GraniteGobbler/VFDClock/README.md

# VFDClock
A table clock with 7-segment VFD tubes running on an ESP32-S3 MCU.

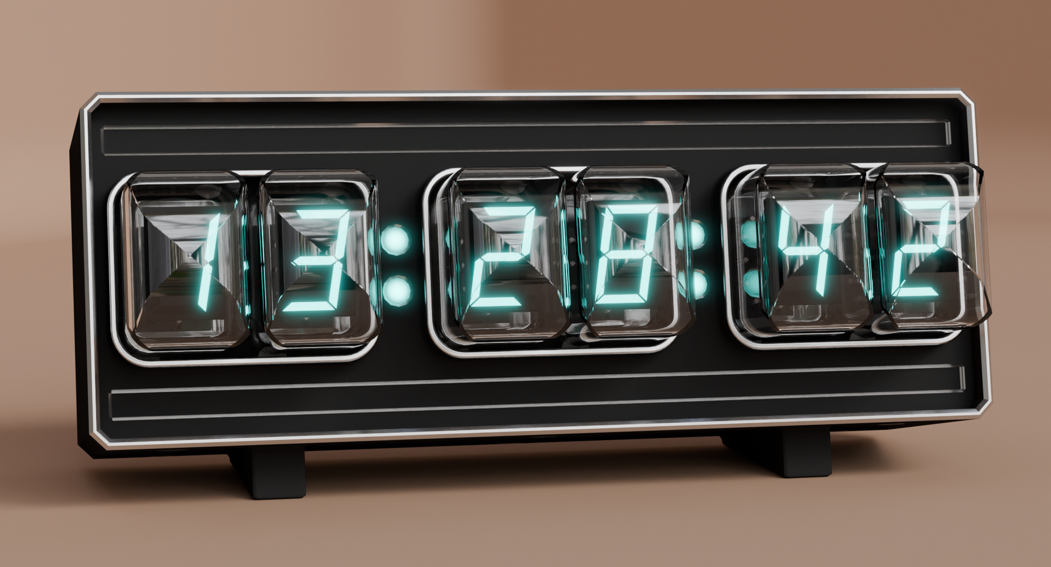
[picture p1: img/render_crop.png]
Front Render


## Showcase
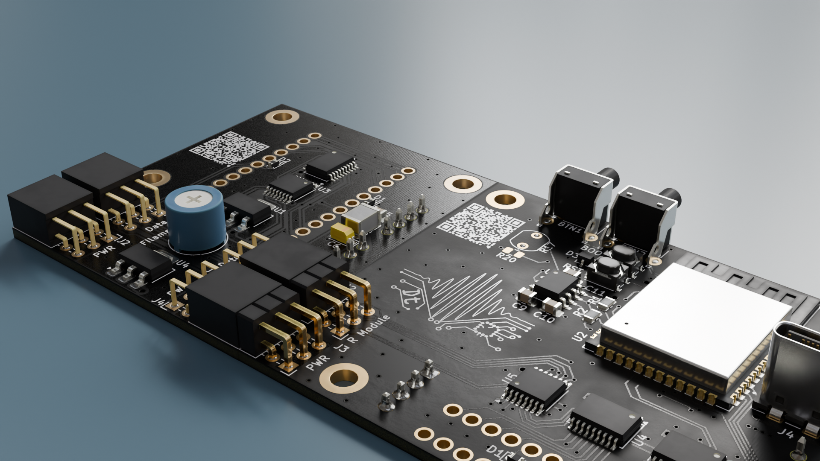
[picture p2: img/PCB renders/assembly_top_detail.png]
Board Assembly
