GraniteGobbler/VFDClock/img/PCB renders/bottom.png

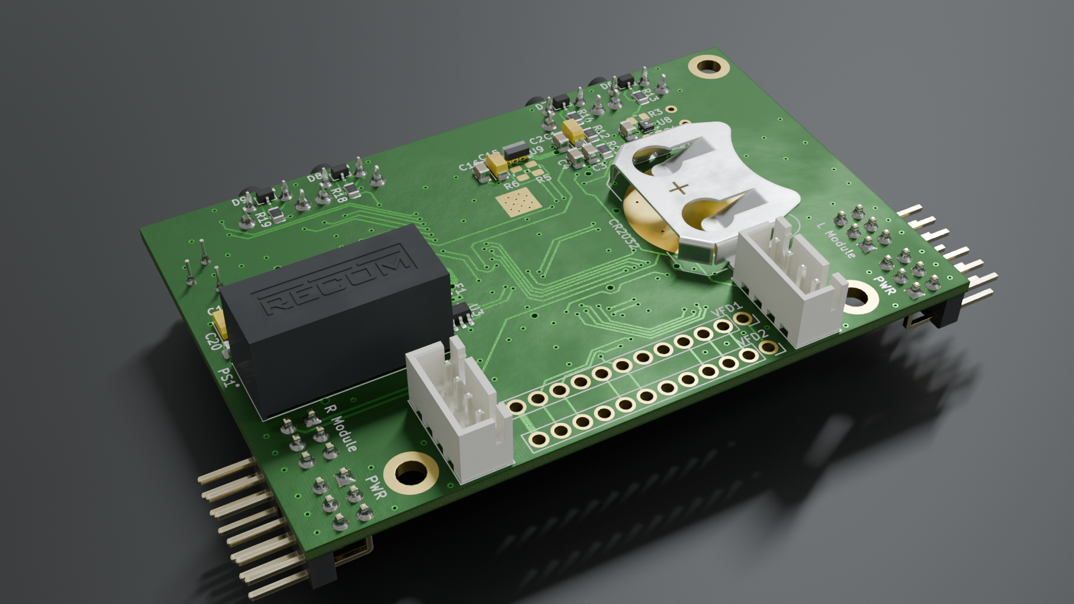
img/PCB renders/bottom.png
