GraniteGobbler/VFDClock/img/PCB renders/top.png

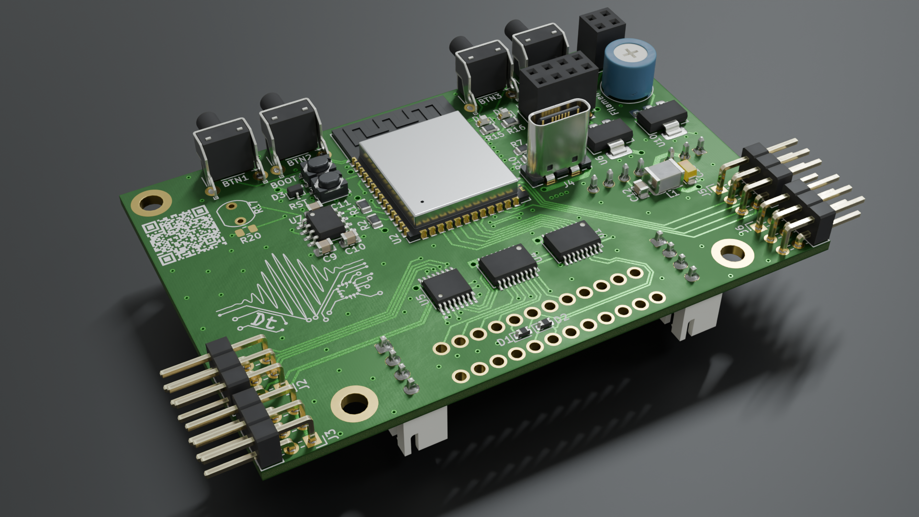
img/PCB renders/top.png
