GraniteGobbler/VFDClock/img/render1.png

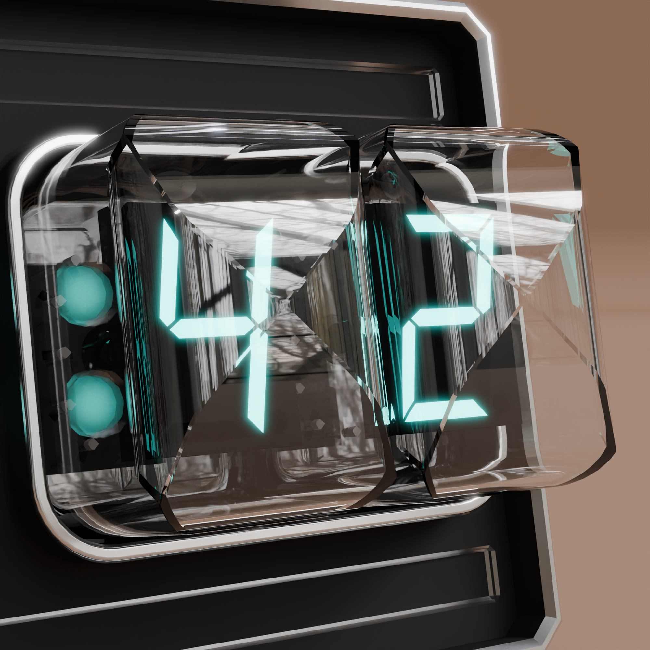
img/render1.png
