GraniteGobbler/VFDClock/img/render.png

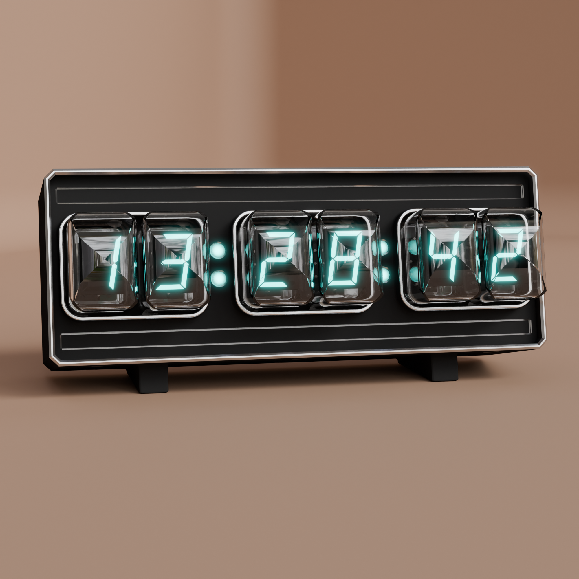
img/render.png
