GraniteGobbler/VFDClock/img/repo_social.png

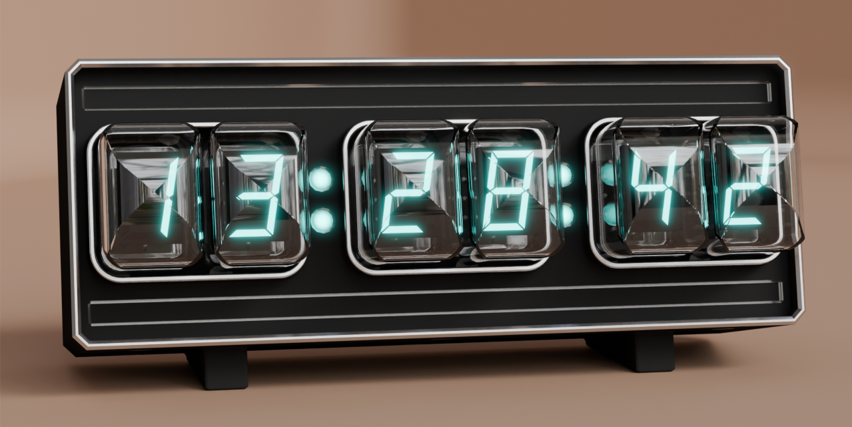
img/repo_social.png
