GraniteGobbler/VFDClock/pcb/pinout.png

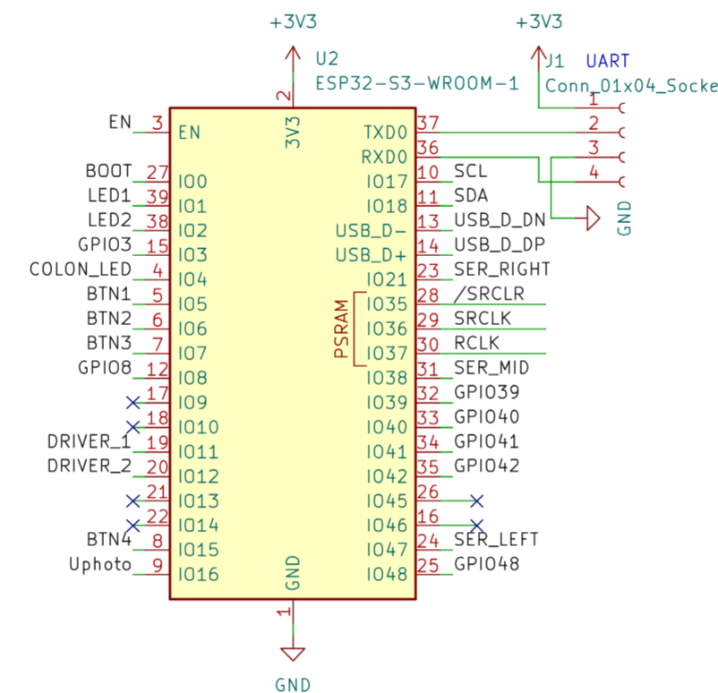
pcb/pinout.png
