GraniteGobbler/VFDClock/hw/VFDClock_assembly.SLDASM

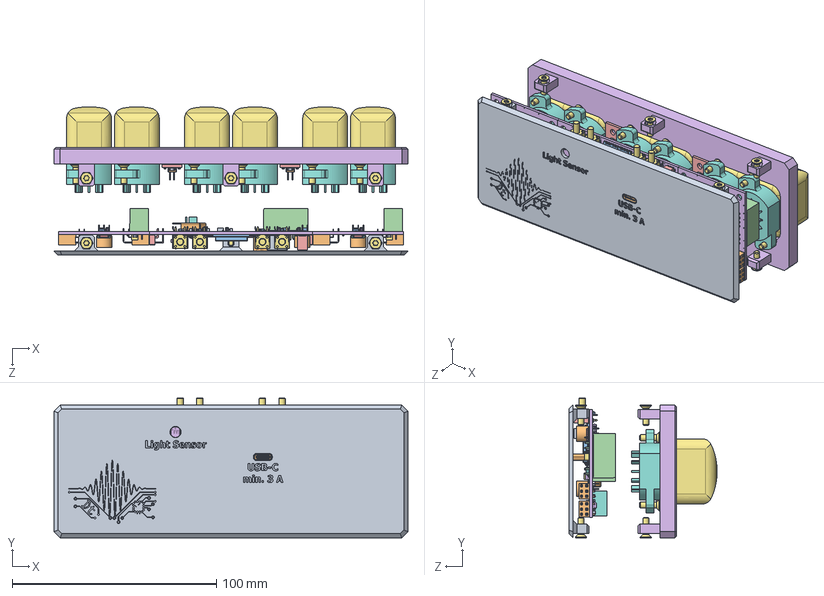
[picture p9: CAD file, 2025-09-25]
hw/VFDClock_assembly.SLDASM
173.3 x 68.4 x 72.6 mm
PinSocket_2x03_P2.54mm_Horizontal.step x 8
D_0603_1608Metric.step x 6
TSSOP-16_4.4x5mm_P0.65mm.step x 3
SSOP-18_4.4x6.5mm_P0.65mm.step x 4
CP_EIA-3216-18_Kemet-A.step x 11
L_1812_4532Metric.step x 3
SOT-223.step x 6
C_0805_2012Metric.step x 27
Potentiometer_Bourns_3339P_Vertical.step x 3
CP_EIA-3528-15_AVX-H.step x 6
Module 1.22.step x 2
Module_silkscreen.step x 2
Module_PCB.step x 2
terminal^Vishay_-_VEML3235SL.step.step
base.step.step
top^Vishay_-_VEML3235SL.step.step
logo^Vishay_-_VEML3235SL.step.step
SOT-323_SC-70.step x 5
LED_0603_1608Metric.step x 2
PinHeader_2x03_P2.54mm_Horizontal.step x 4
R_0805_2012Metric.step x 23
SW_Tactile_SPST_Angled_PTS645Vx83-2LFS.step x 4
PTS810SJK250SMTR_LFS-v2.step x 2
PinSocket_2x04_P2.54mm_Vertical_SMD.step
UJ20-C-V-C-2-SMT-TR-v2.step
ESP32-S3-WROOM-1.step
SOIC-8_3.9x4.9mm_P1.27mm.step
PinSocket_2x02_P2.54mm_Vertical_SMD.step
R_LDR_5.1x4.3mm_P3.4mm_Vertical.step
Fuse_0603_1608Metric.step
JST_XH_B4B-XH-A_1x04_P2.50mm_Vertical.step x 2
SC-74-6_1.55x2.9mm_P0.95mm.step
BatteryHolder_Keystone_3034_1x20mm.step
SHT45-AD1B-R2.step
VFDClock 1.77.step
VFDClock_silkscreen.step
VFDClock_PCB.step
IV-22 x 6
PL31A-P x 6
LED_Inolux_IN-PI554FCH_PLCC4_5.0x5.0mm_P3.2mm.step x 4
PinHeader_2x02_P2.00mm_Vertical.step x 2
SOT-23.step x 2
Separator_silkscreen.step x 2
Separator_PCB.step x 2
CaseCover
FacePlate
M3x10_Torx x 23
