GraniteGobbler/VFDClock/hw/CaseCover.SLDPRT

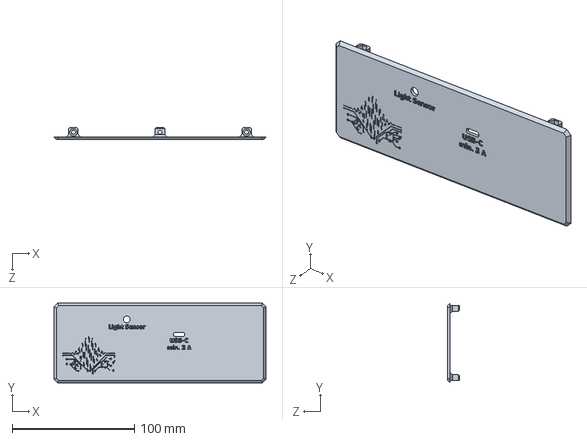
[picture p10: CAD file, 2025-09-25]
hw/CaseCover.SLDPRT
173.3 x 65.0 x 9.80 mm
