GraniteGobbler/VFDClock/module_pcb/Models/SHT45-AD1B-R2.stp

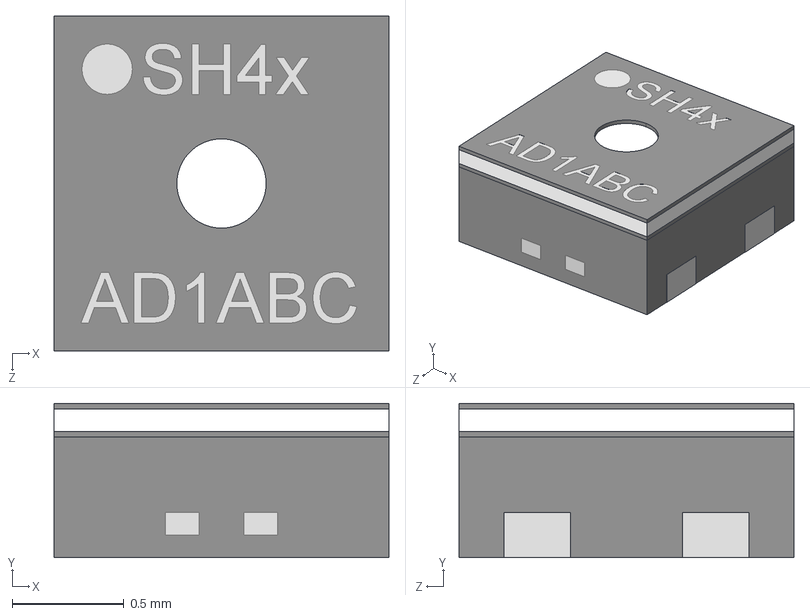
[picture p11: CAD file, 2025-06-01]
module_pcb/Models/SHT45-AD1B-R2.stp
1.50 x 0.691 x 1.50 mm
