GraniteGobbler/VFDClock/separator_pcb/Separator.step

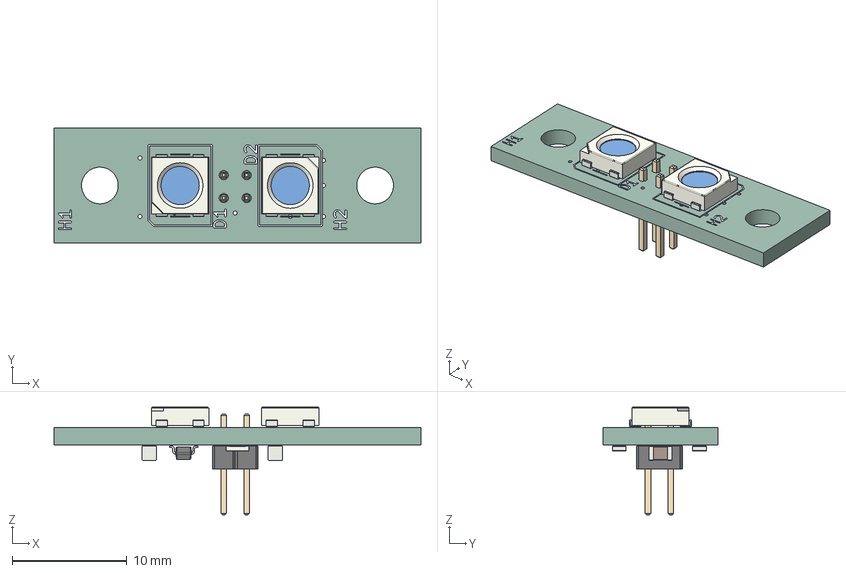
[picture p12: CAD file, 2025-06-04]
separator_pcb/Separator.step
32.0 x 10.0 x 9.38 mm
LED_Inolux_IN-PI554FCH_PLCC4_5.0x5.0mm_P3.2mm x 2
PinHeader_2x02_P2.00mm_Vertical
R_0805_2012Metric x 2
SOT-23
C_0805_2012Metric x 2
Separator_silkscreen
Separator_PCB
