GraniteGobbler/VFDClock/module_pcb/Models/PTS810SJK250SMTR_LFS.stp

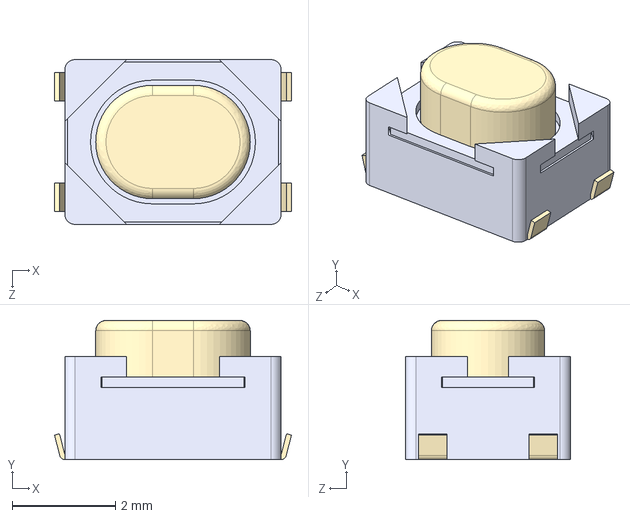
[picture p13: CAD file, 2025-06-01]
module_pcb/Models/PTS810SJK250SMTR_LFS.stp
4.60 x 2.70 x 3.20 mm
