GraniteGobbler/VFDClock/hw/Case.STEP

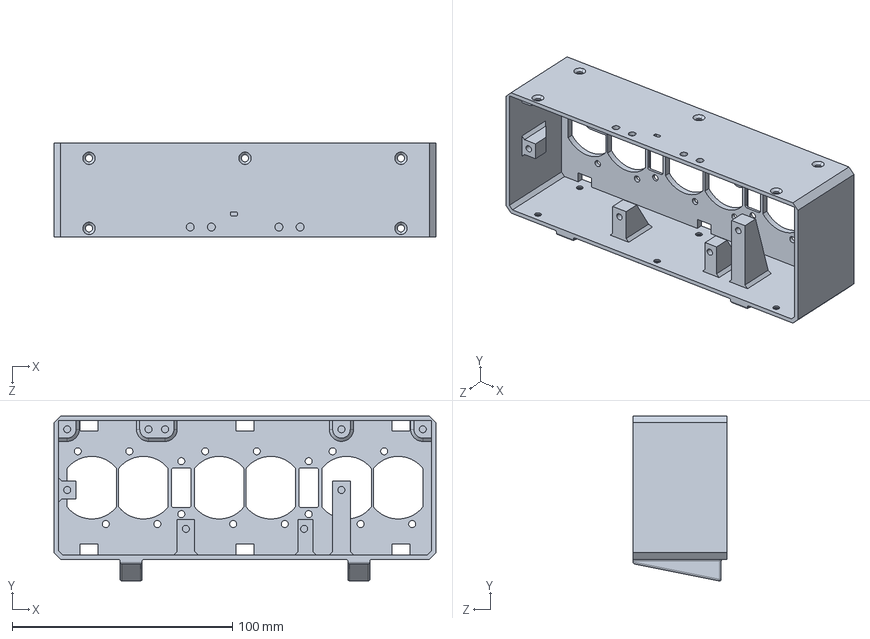
[picture p14: CAD file, 2025-06-16]
hw/Case.STEP
173.3 x 74.8 x 42.6 mm
