GraniteGobbler/VFDClock/module_pcb/Models/UJ20-C-V-C-2-SMT-TR-v2.step

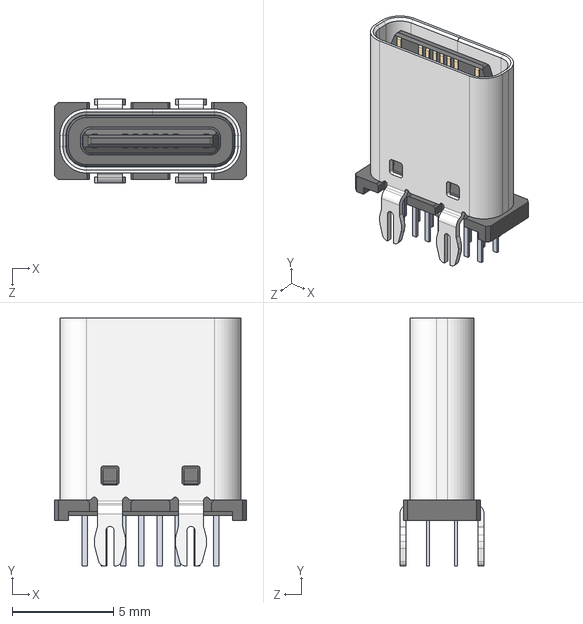
[picture p15: CAD file, 2025-06-01]
module_pcb/Models/UJ20-C-V-C-2-SMT-TR-v2.step
9.50 x 12.2 x 4.16 mm
