GraniteGobbler/VFDClock/hw/FacePlate.STEP

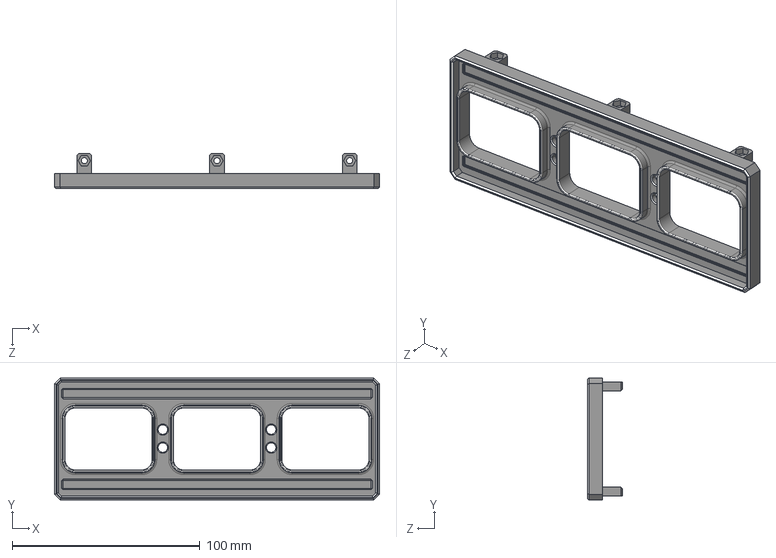
[picture p16: CAD file, 2025-06-16]
hw/FacePlate.STEP
173.3 x 65.0 x 18.8 mm
