GraniteGobbler/VFDClock/module_pcb/Models/VEML3235SL.stp

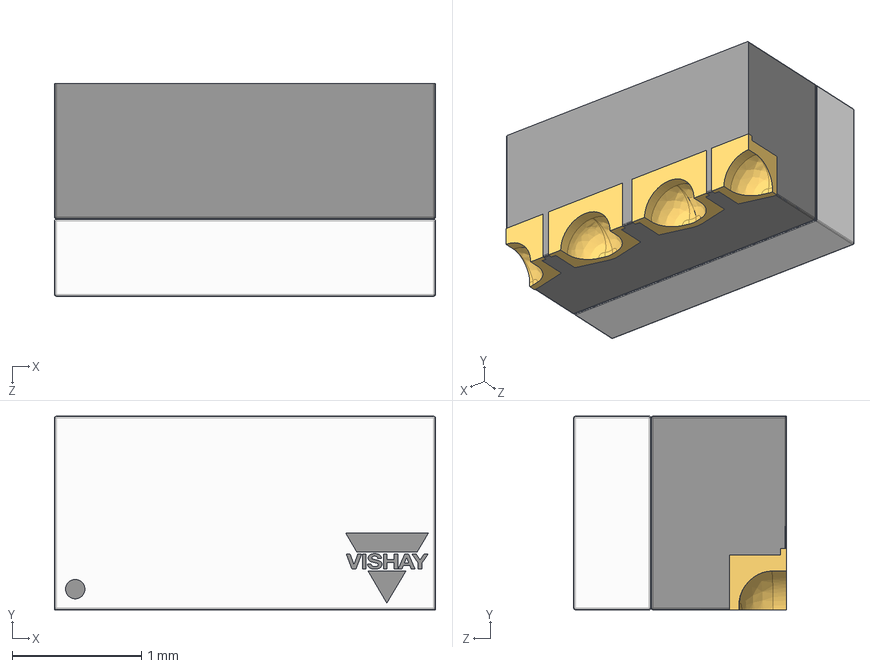
[picture p17: CAD file, 2025-05-31]
module_pcb/Models/VEML3235SL.stp
2.95 x 1.50 x 1.65 mm
terminal^Vishay_-_VEML3235SL.step
base.step
top^Vishay_-_VEML3235SL.step
logo^Vishay_-_VEML3235SL.step
