GraniteGobbler/VFDClock/hw/M3_Torx.SLDPRT

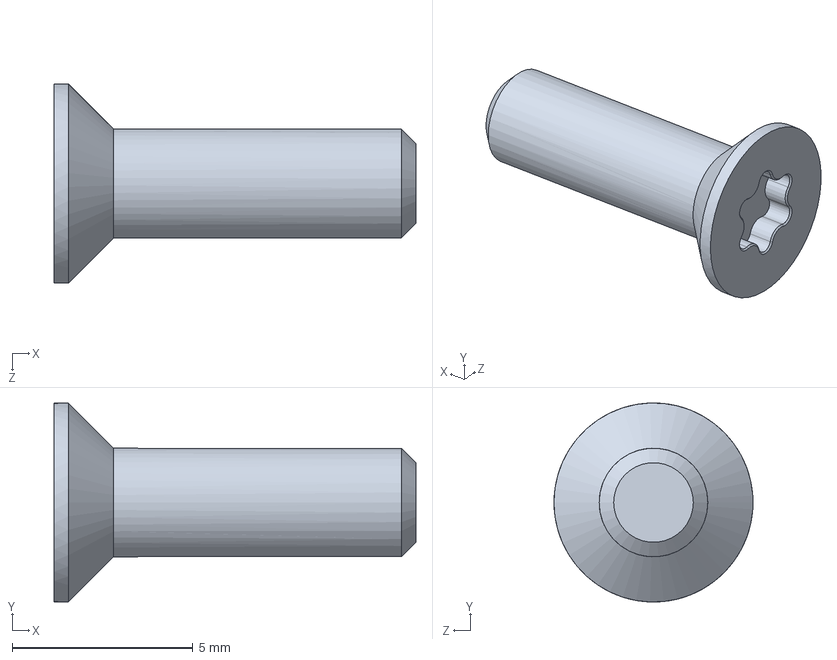
[picture p18: CAD file, 2025-06-14]
hw/M3_Torx.SLDPRT
10.0 x 5.50 x 5.50 mm
