GraniteGobbler/VFDClock/hw/IV-22.SLDPRT

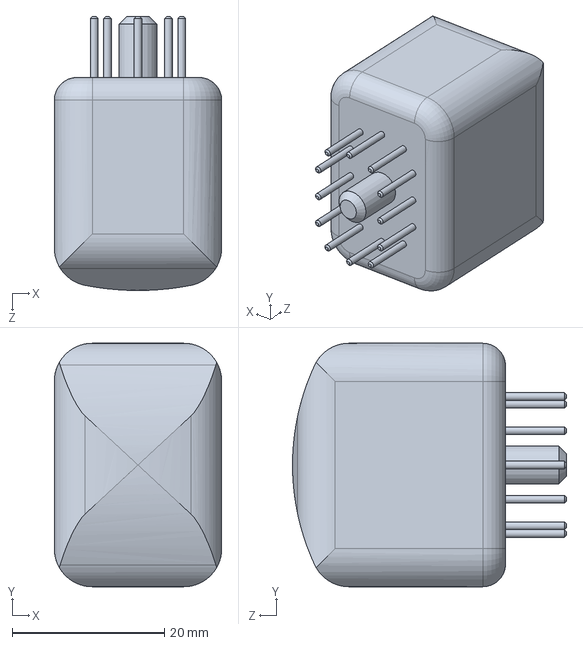
[picture p19: CAD file, 2025-06-13]
hw/IV-22.SLDPRT
22.0 x 32.0 x 36.0 mm
