GraniteGobbler/VFDClock/module_pcb/Models/RS3K-0524S_H3.step

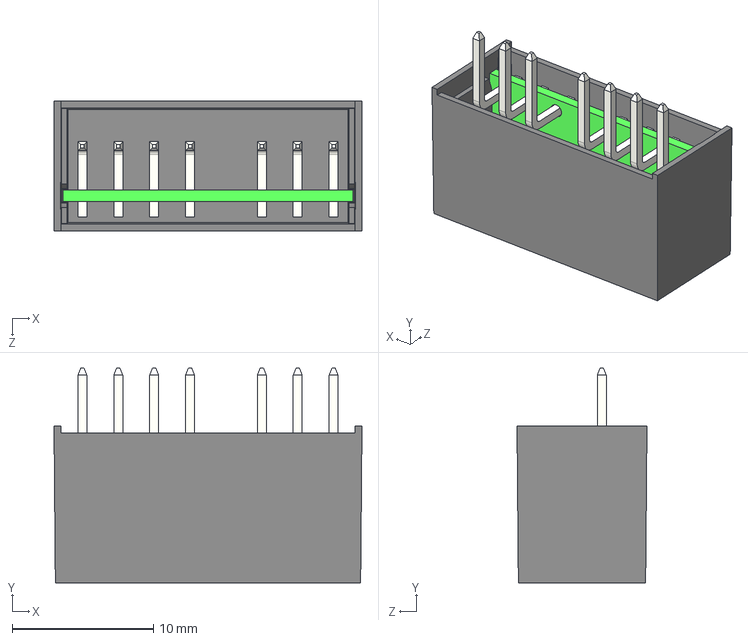
[picture p20: CAD file, 2025-05-25]
module_pcb/Models/RS3K-0524S_H3.step
21.8 x 15.2 x 9.20 mm
