GraniteGobbler/VFDClock/hw/logo.dxf

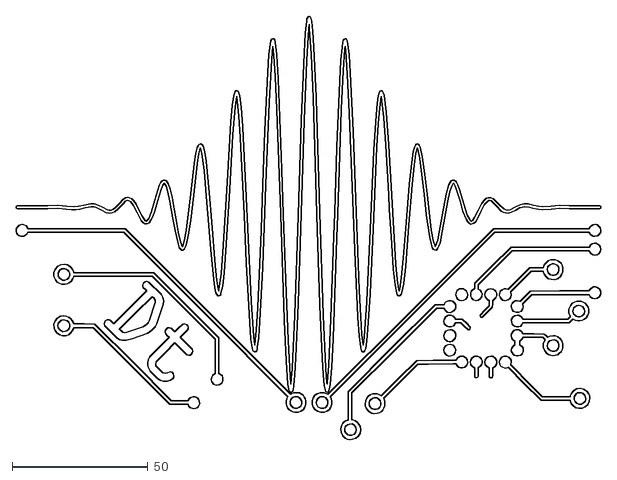
[picture p21: CAD file, 2025-06-13]
hw/logo.dxf
215.1 x 155.7
