GraniteGobbler/VFDClock/hw/PL31A-P.SLDPRT

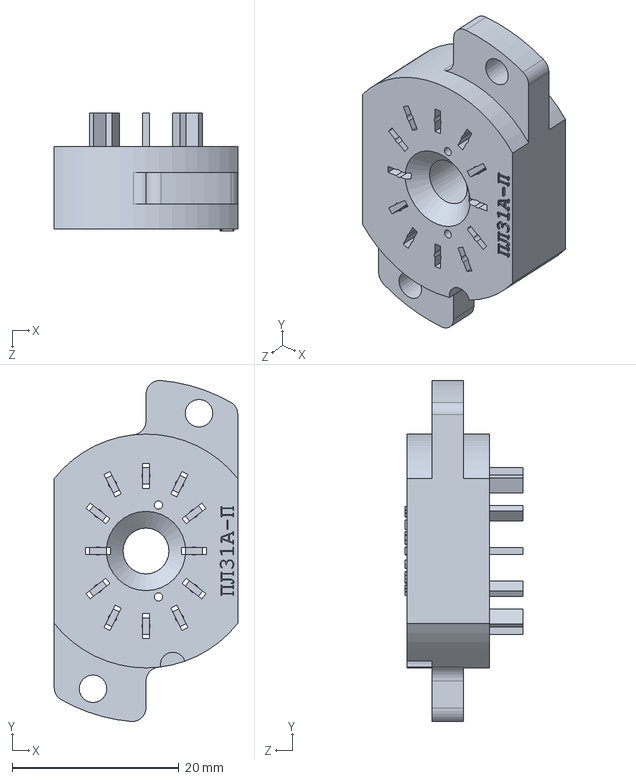
[picture p22: CAD file, 2025-06-13]
hw/PL31A-P.SLDPRT
22.0 x 40.8 x 14.1 mm
