GraniteGobbler/VFDClock/(list of files, cad)

Other CAD files:
module_pcb/Models/PTS810SJK250SMTR_LFS-v2.STEP
module_pcb/Models/UJ20-C-V-C-2-SMT-TR.step
hw/top^Vishay_-_VEML3235SL.step.step.SLDPRT
hw/logo^Vishay_-_VEML3235SL.step.step.SLDPRT
hw/BatteryHolder_Keystone_3034_1x20mm.step.SLDPRT
hw/terminal^Vishay_-_VEML3235SL.step.step.SLDPRT
hw/Separator_PCB.step.SLDPRT
hw/base.step.step.SLDPRT
hw/VFDClock_PCB.step.SLDPRT
hw/Separator_silkscreen.step.SLDPRT
hw/VFDClock 1.77.step.SLDPRT
hw/VFDClock_silkscreen.step.SLDPRT
hw/Module_silkscreen.step.SLDPRT
hw/Module 1.22.step.SLDPRT
hw/Case.SLDPRT
hw/FacePlate.SLDPRT
hw/M3x10_Torx.SLDPRT
