GraniteGobbler/VFDClock/img/PCB renders/assembly_top.png

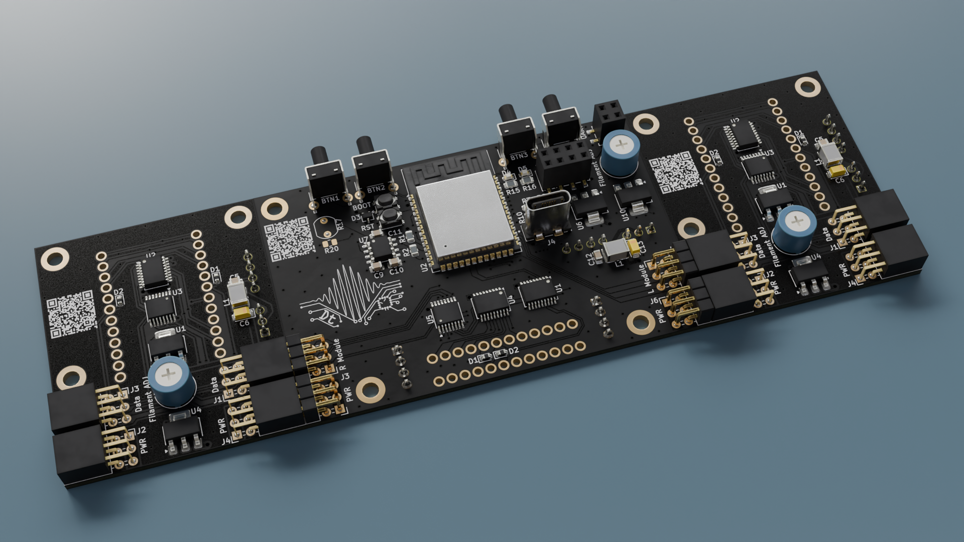
img/PCB renders/assembly_top.png
