GraniteGobbler/VFDClock/pcb/schematic_sheet.pdf

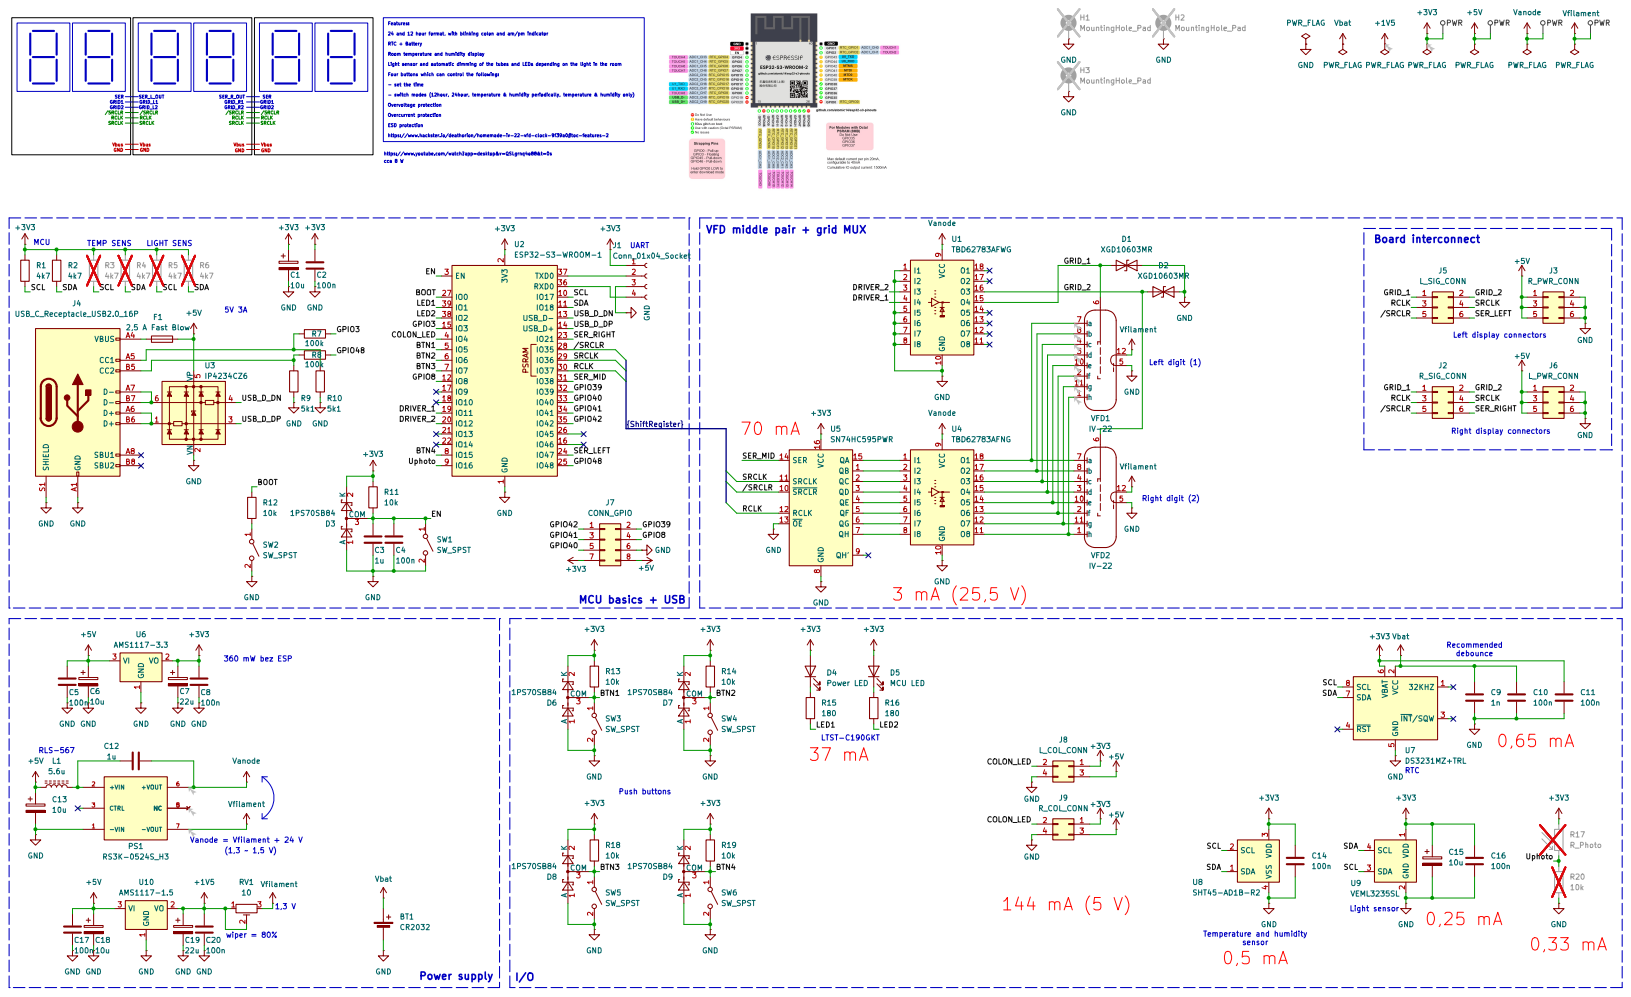
[picture p24: page 1]
