GraniteGobbler/VFDClock/module_pcb/Module.kicad_pcb

## KiCad design module_pcb/Module.kicad_pcb (2025-06-19)

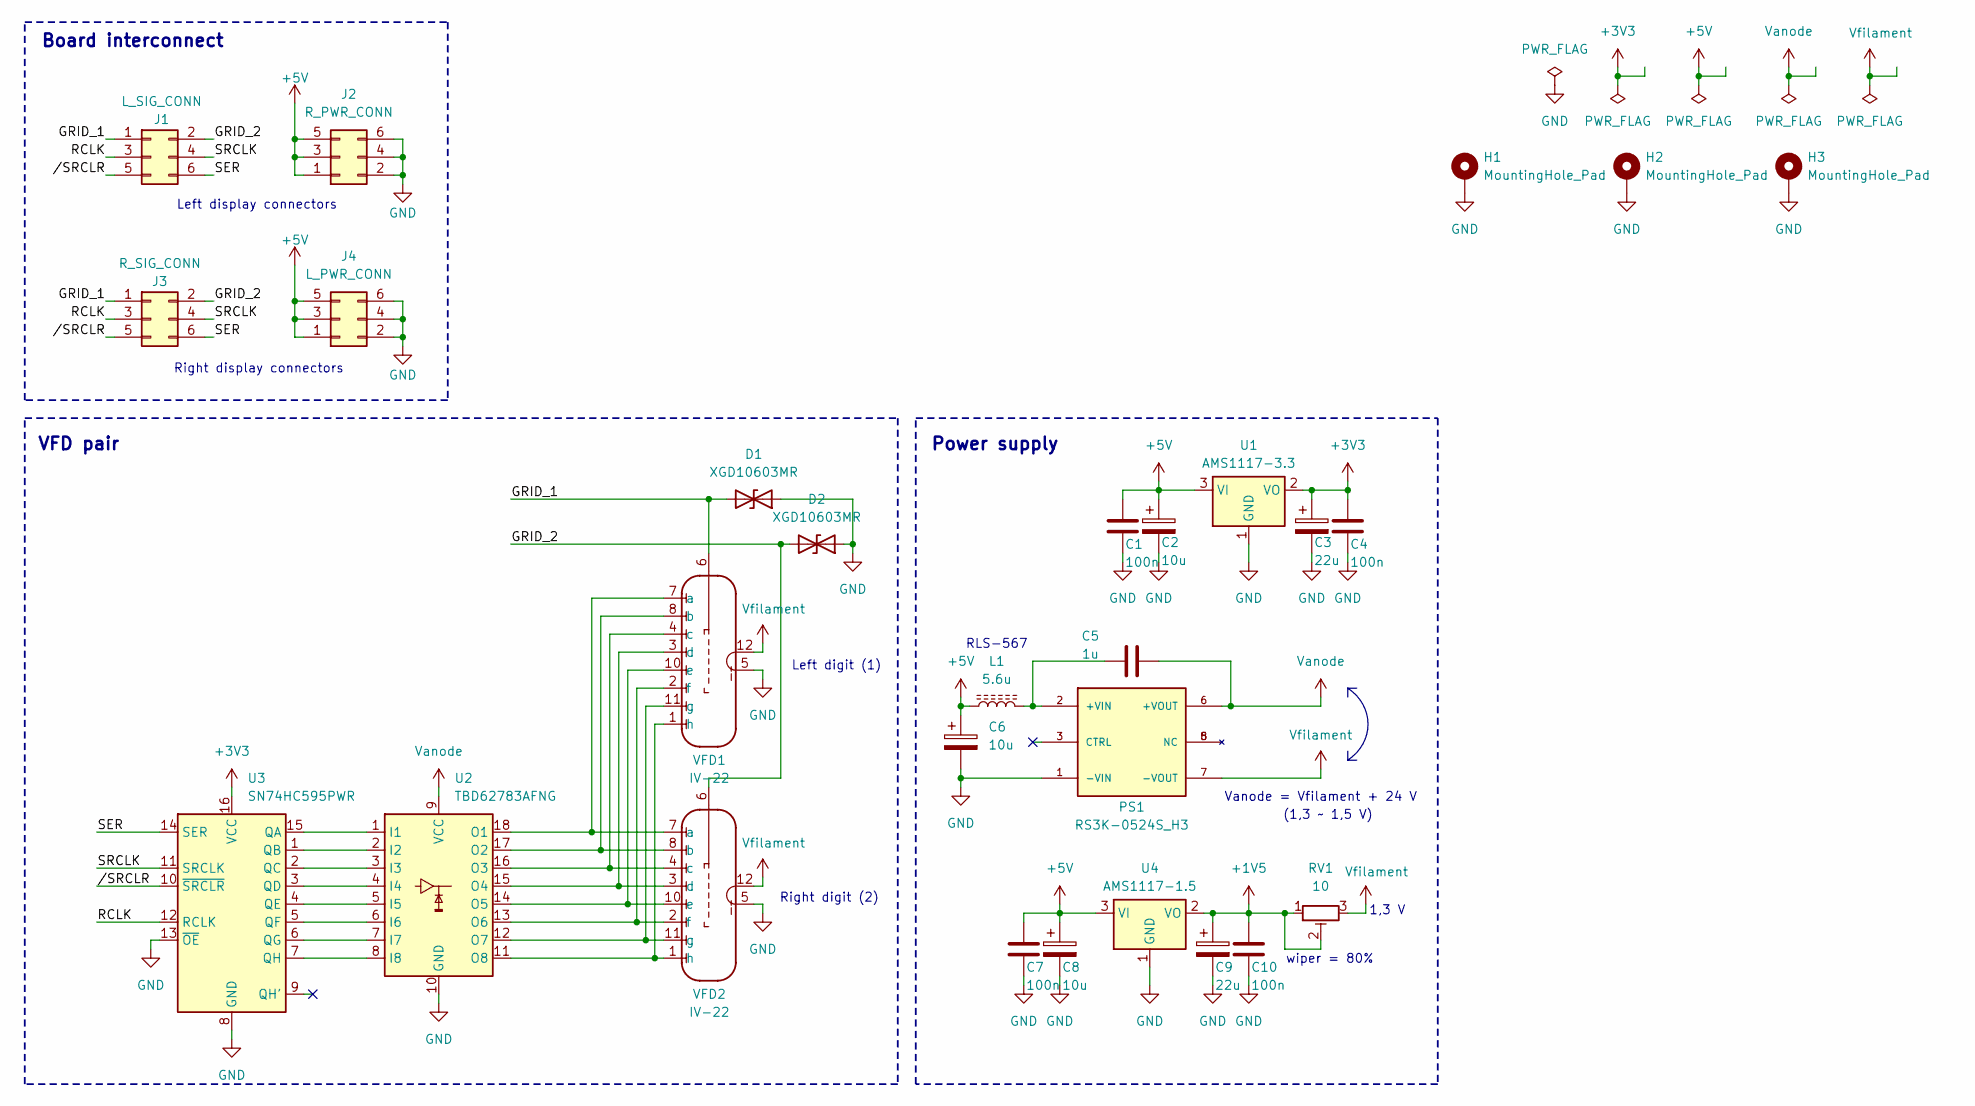
[picture p25: schematic Module.kicad_sch]

Parts:
C1, C4, C7, C10: 100n; C_0805_2012Metric
C2, C6, C8: 10u; CP_EIA-3216-18_Kemet-A
C3, C9: 22u; CP_EIA-3216-18_Kemet-A
C5: 1u; C_0805_2012Metric
D1, D2: XGD10603MR; D_0603_1608Metric
H1, H2, H3: MountingHole_Pad; MountingHole_3.2mm_M3_ISO14580_Pad_TopBottom
J1: L_SIG_CONN; PinSocket_2x03_P2.54mm_Horizontal
J2: R_PWR_CONN; PinSocket_2x03_P2.54mm_Horizontal
J3: R_SIG_CONN; PinSocket_2x03_P2.54mm_Horizontal
J4: L_PWR_CONN; PinSocket_2x03_P2.54mm_Horizontal
L1: 5.6u; L_1812_4532Metric
PS1: RS3K-0524S_H3; CONV_RS3K-0524S_H3; PARTREV 2-2024
RV1: 10; Potentiometer_Bourns_3339P_Vertical
U1: AMS1117-3.3; SOT-223-3_TabPin2
U2: TBD62783AFNG; SSOP-18_4.4x6.5mm_P0.65mm
U3: SN74HC595PWR; TSSOP-16_4.4x5mm_P0.65mm
U4: AMS1117-1.5; SOT-223-3_TabPin2
VFD1, VFD2: IV-22; PinSocket_1x12_P2.54mm_Vertical

Connections:
+1V5: C9.1, C10.1, RV1.1, RV1.2, U4.2 (VO)
+3V3: C3.1, C4.1, U1.2 (VO), U3.16 (VCC)
+5V: C1.1, C2.1, C6.1, C7.1, C8.1, J2.1, J2.3, J2.5, J4.1, J4.3, J4.5, L1.1, U1.3 (VI), U4.3 (VI)
/GRID_1: D1.2 (A2), J1.1, J3.1, VFD1.6
/GRID_2: D2.2 (A2), J1.2, J3.2, VFD2.6
/RCLK: J1.3, J3.3, U3.12 (RCLK)
/SER: J1.6, J3.6, U3.14 (SER)
/SRCLK: J1.4, J3.4, U3.11 (SRCLK)
//SRCLR: J1.5, J3.5, U3.10 (~SRCLR)
GND: C1.2, C2.2, C3.2, C4.2, C6.2, C7.2, C8.2, C9.2, C10.2, D1.1 (A1), D2.1 (A1), H1.1, H2.1, H3.1, J2.2, J2.4, J2.6, J4.2, J4.4, J4.6, PS1.1 (-VIN), U1.1 (GND), U2.10 (GND), U3.8 (GND), U3.13 (~OE), U4.1 (GND), VFD1.5, VFD2.5
unnamed: C5.1, L1.2, PS1.2 (+VIN)
unnamed: U2.1 (I1), U3.15 (QA)
unnamed: U2.2 (I2), U3.1 (QB)
unnamed: U2.3 (I3), U3.2 (QC)
unnamed: U2.4 (I4), U3.3 (QD)
unnamed: U2.5 (I5), U3.4 (QE)
unnamed: U2.6 (I6), U3.5 (QF)
unnamed: U2.7 (I7), U3.6 (QG)
unnamed: U2.8 (I8), U3.7 (QH)
unnamed: U2.18 (O1), VFD1.7 (a), VFD2.7 (a)
unnamed: U2.17 (O2), VFD1.8 (b), VFD2.8 (b)
unnamed: U2.16 (O3), VFD1.4 (c), VFD2.4 (c)
unnamed: U2.15 (O4), VFD1.3 (d), VFD2.3 (d)
unnamed: U2.14 (O5), VFD1.10 (e), VFD2.10 (e)
unnamed: U2.13 (O6), VFD1.2 (f), VFD2.2 (f)
unnamed: U2.12 (O7), VFD1.11 (g), VFD2.11 (g)
unnamed: U2.11 (O8), VFD1.1 (h), VFD2.1 (h)
Vanode: C5.2, PS1.6 (+VOUT), U2.9 (VCC)
Vfilament: PS1.7 (-VOUT), RV1.3, VFD1.12, VFD2.12

Notes on the sheet:
Right digit (2)
Left digit (1)
RLS-567
Power supply
Vanode = Vfilament + 24 V
1,3 V
VFD pair
Board interconnect
wiper = 80%
(1,3 ~ 1,5 V)
Left display connectors
Right display connectors

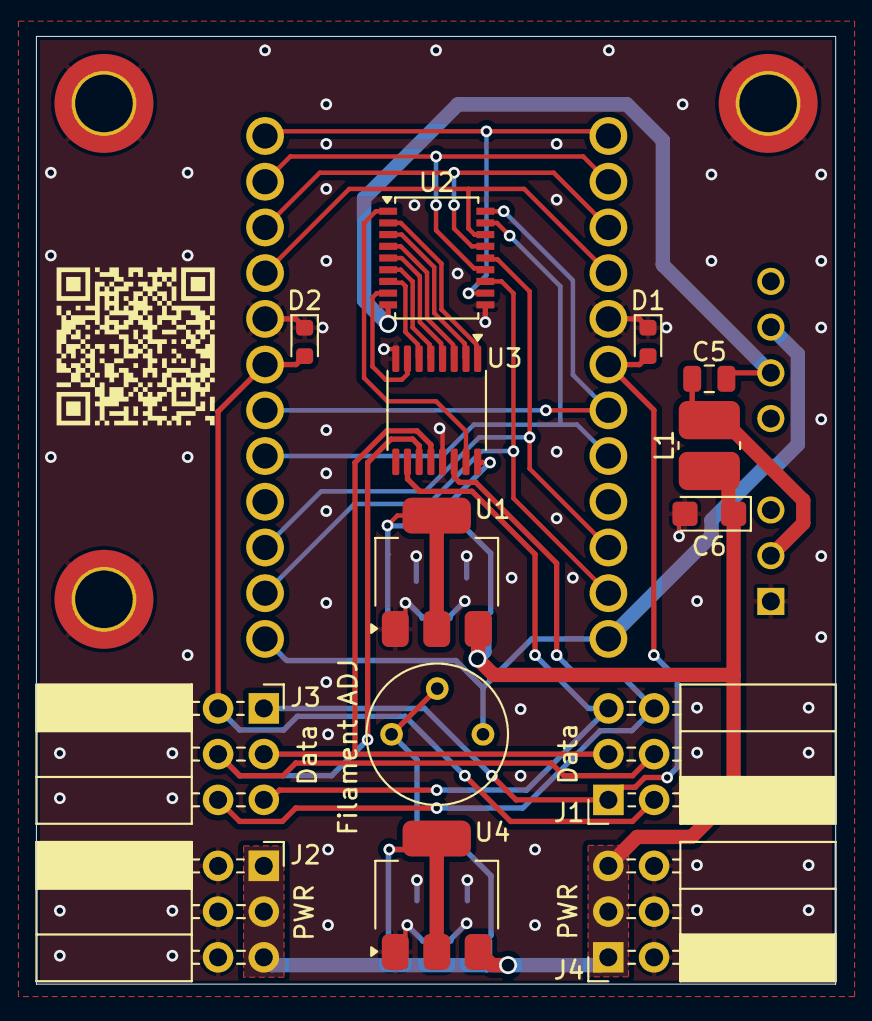
[picture p26: board Module.kicad_pcb from above]

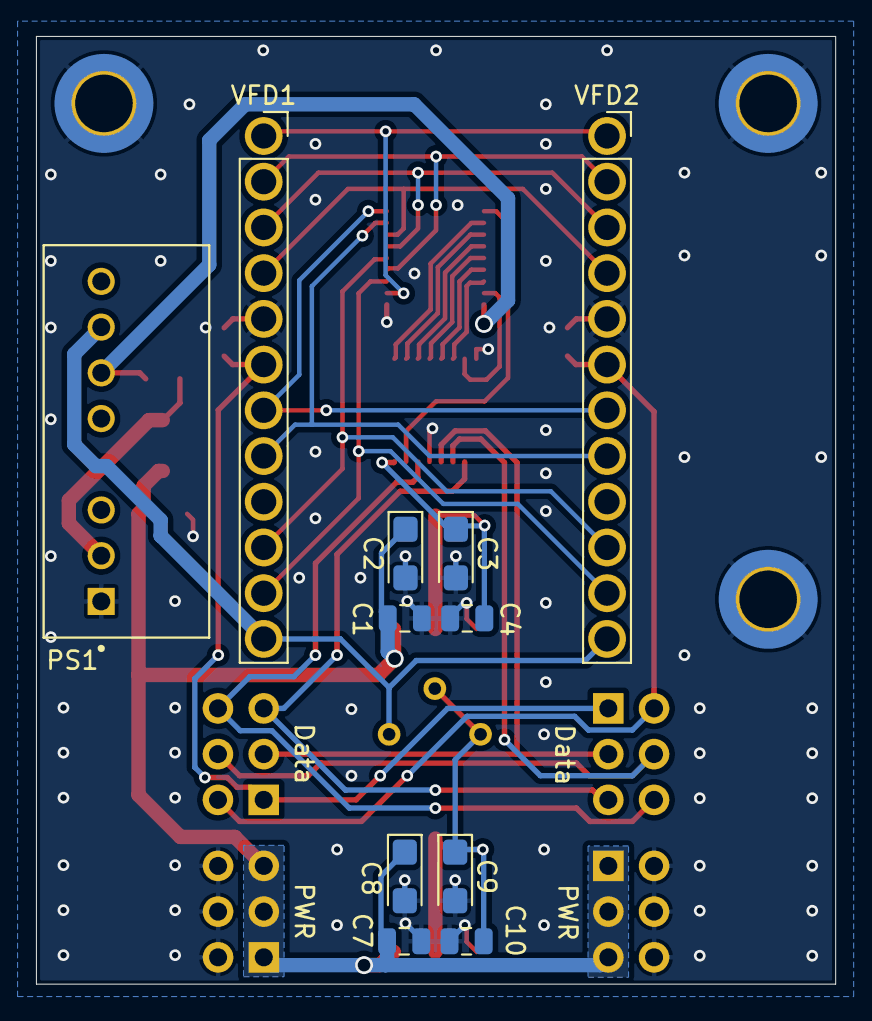
[picture p27: board Module.kicad_pcb from below]

Board: 2 copper layers, 44.4 x 52.7 mm, 28 parts (11 on the bottom side), 29 nets.
