GraniteGobbler/VFDClock/pcb/VFDClock.kicad_pcb

## KiCad design pcb/VFDClock.kicad_pcb (2025-06-19)

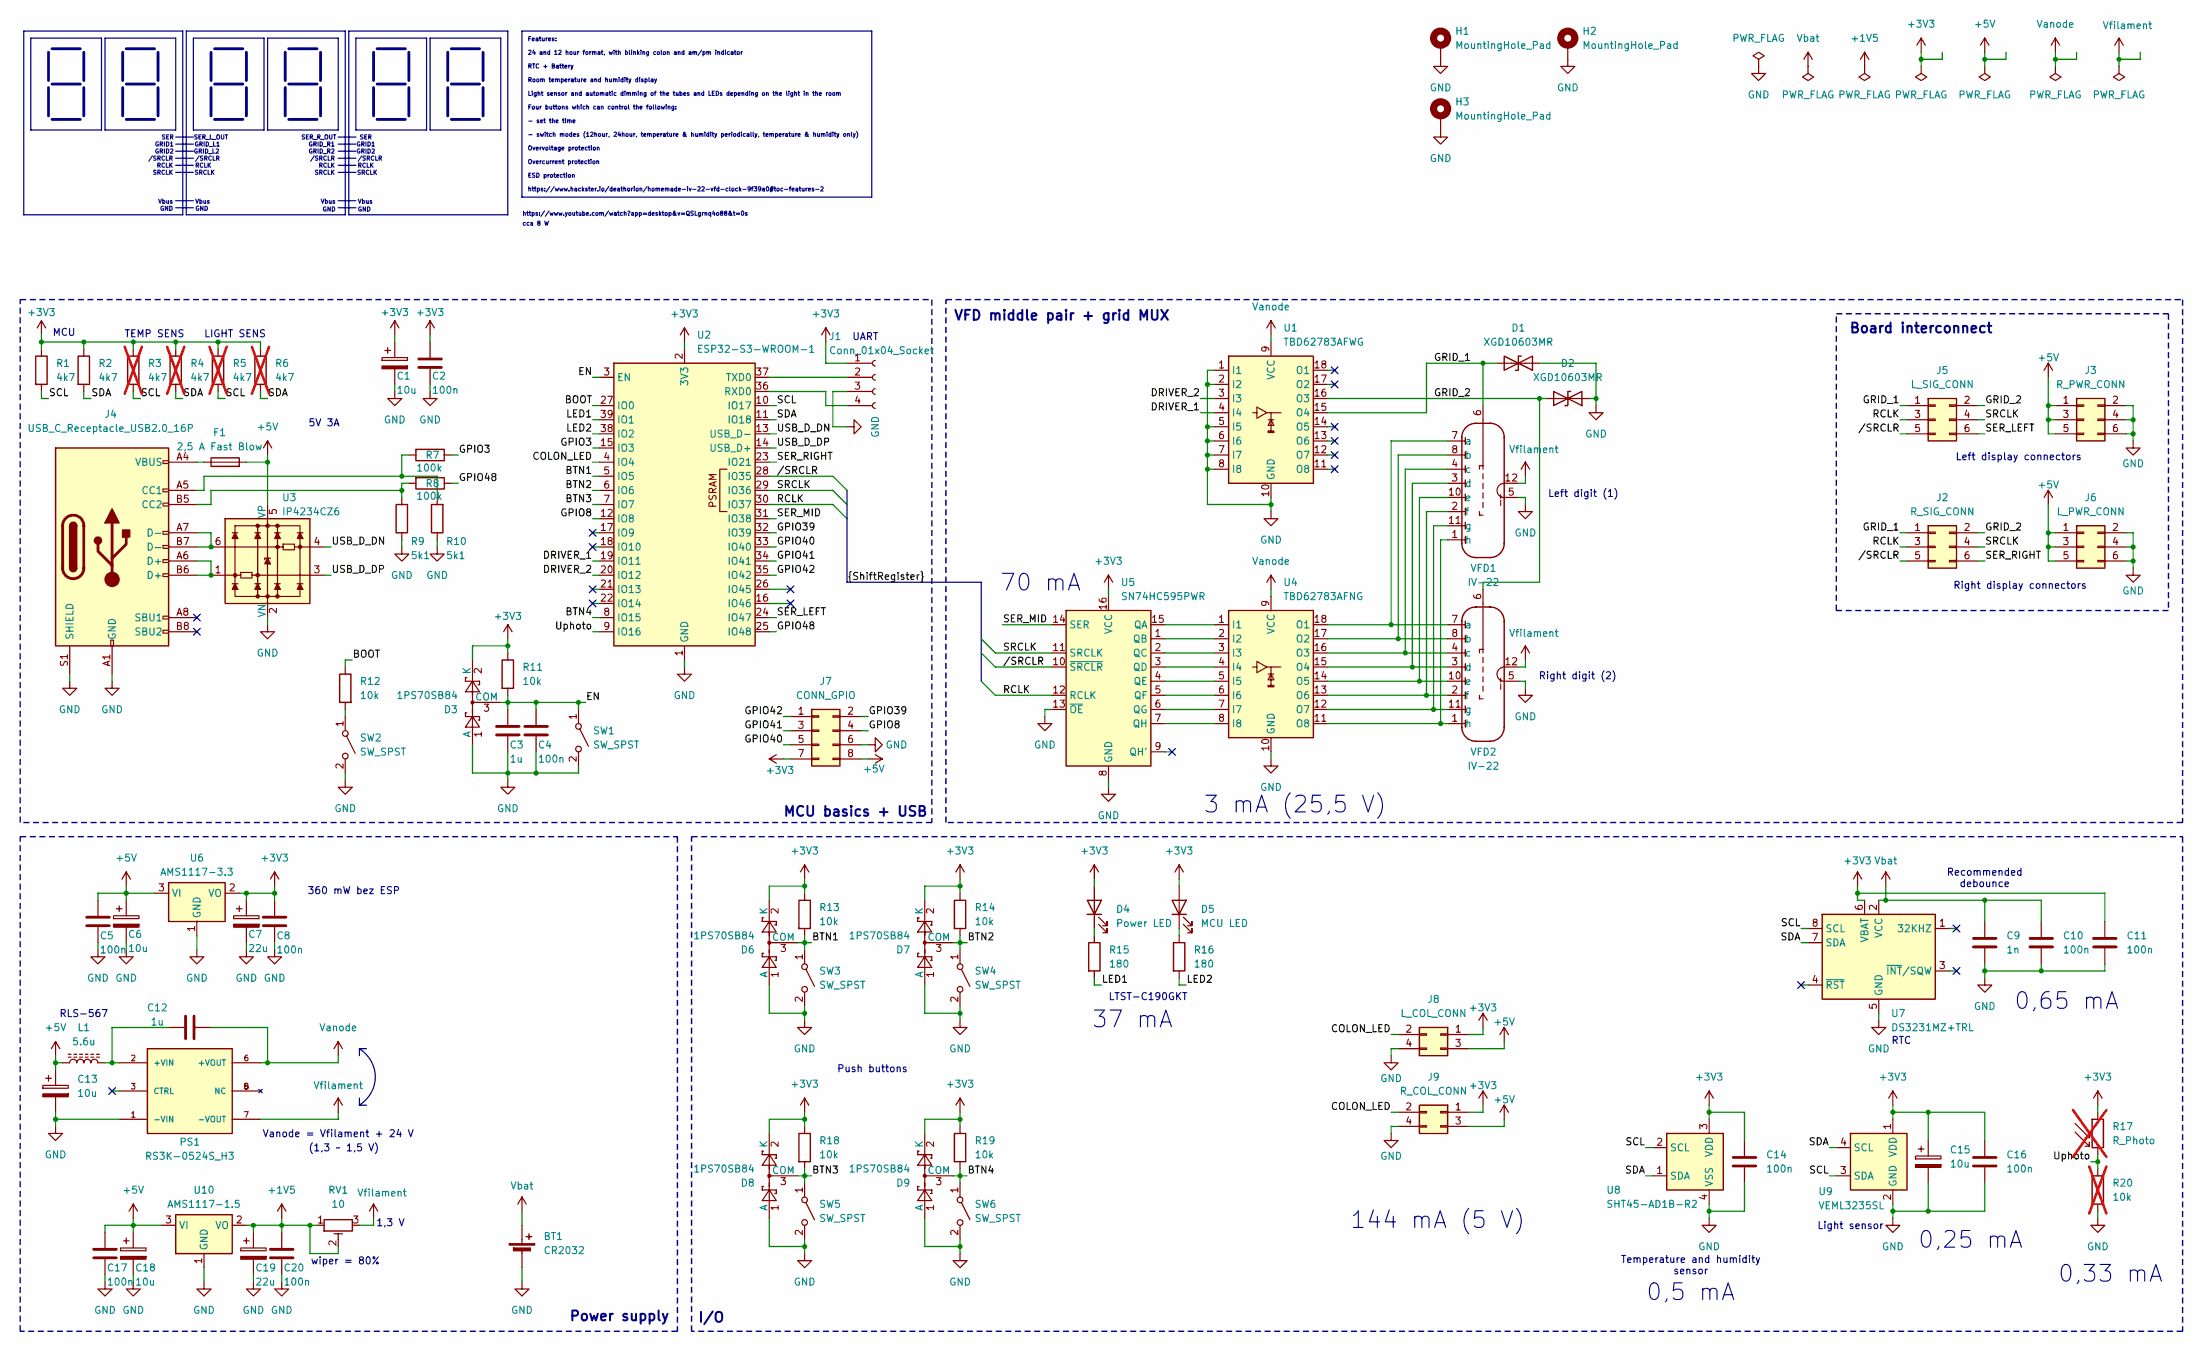
[picture p28: schematic VFDClock.kicad_sch]

Parts:
BT1: CR2032; BatteryHolder_Keystone_3034_1x20mm
C1, C6, C13, C15, C18: 10u; CP_EIA-3216-18_Kemet-A
C2, C4, C5, C8, C10, C11, C14, C16, C17, C20: 100n; C_0805_2012Metric
C3, C12: 1u; C_0805_2012Metric
C7, C19: 22u; CP_EIA-3216-18_Kemet-A
C9: 1n; C_0805_2012Metric
D1, D2: XGD10603MR; D_0603_1608Metric
D3, D6, D7, D8, D9: 1PS70SB84; SOT-323_SC-70
D4: Power LED; LED_0603_1608Metric
D5: MCU LED; LED_0603_1608Metric
F1: 2,5 A Fast Blow; Fuse_0603_1608Metric
H1, H2, H3: MountingHole_Pad; MountingHole_3.2mm_M3_ISO14580_Pad_TopBottom
J1: Conn_01x04_Socket; PinSocket_2x02_P2.54mm_Vertical_SMD
J2: R_SIG_CONN; PinHeader_2x03_P2.54mm_Horizontal
J3: R_PWR_CONN; PinHeader_2x03_P2.54mm_Horizontal
J4: USB_C_Receptacle_USB2.0_16P; CUI_UJ20-C-V-C-2-SMT-TR
J5: L_SIG_CONN; PinHeader_2x03_P2.54mm_Horizontal
J6: L_PWR_CONN; PinHeader_2x03_P2.54mm_Horizontal
J7: CONN_GPIO; PinSocket_2x04_P2.54mm_Vertical_SMD
J8: L_COL_CONN; JST_XH_B4B-XH-A_1x04_P2.50mm_Vertical
J9: R_COL_CONN; JST_XH_B4B-XH-A_1x04_P2.50mm_Vertical
L1: 5.6u; L_1812_4532Metric
PS1: RS3K-0524S_H3; CONV_RS3K-0524S_H3; PARTREV 2-2024
R1, R2: 4k7; R_0805_2012Metric
R3, R4, R5, R6: 4k7; R_0805_2012Metric; not fitted
R7, R8: 100k; R_0805_2012Metric
R9, R10: 5k1; R_0805_2012Metric
R11, R12, R13, R14, R18, R19: 10k; R_0805_2012Metric
R15, R16: 180; R_0805_2012Metric
R17: R_Photo; R_LDR_5.1x4.3mm_P3.4mm_Vertical; not fitted
R20: 10k; R_0805_2012Metric; not fitted
RV1: 10; Potentiometer_Bourns_3339P_Vertical
SW1, SW2: SW_SPST; SW_SPST_PTS810
SW3, SW4, SW5, SW6: SW_SPST; SW_Tactile_SPST_Angled_PTS645Vx83-2LFS
U1: TBD62783AFWG; SSOP-18_4.4x6.5mm_P0.65mm
U2: ESP32-S3-WROOM-1
U3: IP4234CZ6; SC-74-6_1.55x2.9mm_P0.95mm
U4: TBD62783AFNG; SSOP-18_4.4x6.5mm_P0.65mm
U5: SN74HC595PWR; TSSOP-16_4.4x5mm_P0.65mm
U6: AMS1117-3.3; SOT-223-3_TabPin2
U7: DS3231MZ+TRL; SOIC-8_3.9x4.9mm_P1.27mm
U8: SHT45-AD1B-R2; Sensirion_DFN-4_1.5x1.5mm_P0.8mm_SHT4x_NoCentralPad
U9: VEML3235SL; VEML3235SL_Horizontal
U10: AMS1117-1.5; SOT-223-3_TabPin2
VFD1, VFD2: IV-22; PinSocket_1x12_P2.54mm_Vertical

Connections:
+1V5: C19.1, C20.1, RV1.1, RV1.2, U10.2 (VO)
+3V3: C1.1, C2.1, C7.1, C8.1, C11.1, C14.1, C15.1, C16.1, D3.2 (K), D4.2 (A), D5.2 (A), D6.2 (K), D7.2 (K), D8.2 (K), D9.2 (K), J1.1, J7.7, J8.1, J9.1, R1.1, R2.1, R3.1, R4.1, R5.1, R6.1, R11.1, R13.1, R14.1, R17.1, R18.1, R19.1, U2.2 (3V3), U5.16 (VCC), U6.2 (VO), U7.6 (VBAT), U8.3 (VDD), U9.1 (VDD)
+5V: C5.1, C6.1, C13.1, C17.1, C18.1, F1.2, J3.1, J3.3, J3.5, J6.1, J6.3, J6.5, J7.8, J8.3, J9.3, L1.1, U3.5 (VP), U6.3 (VI), U10.3 (VI)
/BOOT: R12.1, U2.27 (IO0)
/BTN1: D6.3 (COM), R13.2, SW3.1 (A), U2.5 (IO5)
/BTN2: D7.3 (COM), R14.2, SW4.1 (A), U2.6 (IO6)
/BTN3: D8.3 (COM), R18.2, SW5.1 (A), U2.7 (IO7)
/BTN4: D9.3 (COM), R19.2, SW6.1 (A), U2.8 (IO15)
/COLON_LED: J8.2, J9.2, U2.4 (IO4)
/DRIVER_1: U1.4 (I4), U2.19 (IO11)
/DRIVER_2: U1.3 (I3), U2.20 (IO12)
/EN: C3.1, C4.1, D3.3 (COM), R11.2, SW1.1 (A), U2.3 (EN)
/GPIO3: R7.1, U2.15 (IO3)
/GPIO8: J7.4, U2.12 (IO8)
/GPIO39: J7.2, U2.32 (IO39)
/GPIO40: J7.5, U2.33 (IO40)
/GPIO41: J7.3, U2.34 (IO41)
/GPIO42: J7.1, U2.35 (IO42)
/GPIO48: R8.1, U2.25 (IO48)
/GRID_1: D1.2 (A2), J2.1, J5.1, U1.15 (O4), VFD1.6
/GRID_2: D2.2 (A2), J2.2, J5.2, U1.16 (O3), VFD2.6
/LED1: R15.2, U2.39 (IO1)
/LED2: R16.2, U2.38 (IO2)
/RCLK: J2.3, J5.3, U2.30 (IO37), U5.12 (RCLK)
/SCL: R1.2, R3.2, R5.2, U2.10 (IO17), U7.8 (SCL), U8.2 (SCL), U9.3 (SDA)
/SDA: R2.2, R4.2, R6.2, U2.11 (IO18), U7.7 (SDA), U8.1 (SDA), U9.4 (SCL)
/SER_LEFT: J5.6, U2.24 (IO47)
/SER_MID: U2.31 (IO38), U5.14 (SER)
/SER_RIGHT: J2.6, U2.23 (IO21)
/SRCLK: J2.4, J5.4, U2.29 (IO36), U5.11 (SRCLK)
/USB_D_DN: U2.13 (USB_D-), U3.4
/USB_D_DP: U2.14 (USB_D+), U3.3
/Uphoto: R17.2, R20.1, U2.9 (IO16)
//SRCLR: J2.5, J5.5, U2.28 (IO35), U5.10 (~SRCLR)
GND: BT1.2 (-), C1.2, C2.2, C3.2, C4.2, C5.2, C6.2, C7.2, C8.2, C9.2, C10.2, C11.2, C13.2, C14.2, C15.2, C16.2, C17.2, C18.2, C19.2, C20.2, D1.1 (A1), D2.1 (A1), D3.1 (A), D6.1 (A), D7.1 (A), D8.1 (A), D9.1 (A), H1.1, H2.1, H3.1, J1.3, J3.2, J3.4, J3.6, J4.A1 (GND), J4.A12 (GND), J4.B1 (GND), J4.B12 (GND), J4.S1 (SHIELD), J6.2, J6.4, J6.6, J7.6, J8.4, J9.4, PS1.1 (-VIN), R9.1, R10.1, R20.2, SW1.2 (B), SW2.2 (B), SW3.2 (B), SW4.2 (B), SW5.2 (B), SW6.2 (B), U1.1 (I1), U1.2 (I2), U1.5 (I5), U1.6 (I6), U1.7 (I7), U1.8 (I8), U1.10 (GND), U2.1 (GND), U2.40 (GND), U2.41 (GND), U3.2 (VN), U4.10 (GND), U5.8 (GND), U5.13 (~OE), U6.1 (GND), U7.5 (GND), U8.4 (VSS), U9.2 (GND), U10.1 (GND), VFD1.5, VFD2.5
unnamed: D4.1 (K), R15.1
unnamed: D5.1 (K), R16.1
unnamed: F1.1, J4.A4 (VBUS), J4.A9 (VBUS), J4.B4 (VBUS), J4.B9 (VBUS)
unnamed: J1.2, U2.37 (TXD0)
unnamed: J1.4, U2.36 (RXD0)
unnamed: J4.A5 (CC1), R7.2, R10.2
unnamed: J4.B5 (CC2), R8.2, R9.2
unnamed: J4.A6 (D+), J4.B6 (D+), U3.1
unnamed: J4.A7 (D-), J4.B7 (D-), U3.6
unnamed: C12.1, L1.2, PS1.2 (+VIN)
unnamed: R12.2, SW2.1 (A)
unnamed: U4.1 (I1), U5.15 (QA)
unnamed: U4.2 (I2), U5.1 (QB)
unnamed: U4.3 (I3), U5.2 (QC)
unnamed: U4.4 (I4), U5.3 (QD)
unnamed: U4.5 (I5), U5.4 (QE)
unnamed: U4.6 (I6), U5.5 (QF)
unnamed: U4.7 (I7), U5.6 (QG)
unnamed: U4.8 (I8), U5.7 (QH)
unnamed: U4.18 (O1), VFD1.7 (a), VFD2.7 (a)
unnamed: U4.17 (O2), VFD1.8 (b), VFD2.8 (b)
unnamed: U4.16 (O3), VFD1.4 (c), VFD2.4 (c)
unnamed: U4.15 (O4), VFD1.3 (d), VFD2.3 (d)
unnamed: U4.14 (O5), VFD1.10 (e), VFD2.10 (e)
unnamed: U4.13 (O6), VFD1.2 (f), VFD2.2 (f)
unnamed: U4.12 (O7), VFD1.11 (g), VFD2.11 (g)
unnamed: U4.11 (O8), VFD1.1 (h), VFD2.1 (h)
Vanode: C12.2, PS1.6 (+VOUT), U1.9 (VCC), U4.9 (VCC)
Vbat: BT1.1 (+), C9.1, C10.1, U7.2 (VCC)
Vfilament: PS1.7 (-VOUT), RV1.3, VFD1.12, VFD2.12

Notes on the sheet:
TEMP SENS
0,5 mA
Right digit (2)
GRID_R2
3 mA (25,5 V)
0,65 mA
Left digit (1)
Vbus
Push buttons
SRCLK
RTC
Temperature and humidity sensor
RLS-567
MCU
Power supply
UART
GND
0,25 mA
37 mA
GRID2
Vanode = Vfilament + 24 V
RCLK
1,3 V
VFD middle pair + grid MUX
MCU basics + USB
SER_R_OUT
Board interconnect
GRID_R1
SER_L_OUT
wiper = 80%
(1,3 ~ 1,5 V)
144 mA (5 V)
/SRCLR
GRID1
https://www.youtube.com/watch?app=desktop&v=QSLgrnq4o88&t=0s
I/O
LIGHT SENS
GRID_L1
SER
GRID_L2
360 mW bez ESP
5V 3A
Left display connectors
70 mA
Recommended debounce
LTST-C190GKT
Light sensor
Right display connectors
cca 8 W
0,33 mA
Features: 24 and 12 hour format, with blinking colon and am/pm indicator RTC + Battery Room temperature and humidity display Light sensor and automatic dimming of the tubes and LEDs depending on the light in the room Four buttons which can control the following: - set the time - switch modes (12hou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

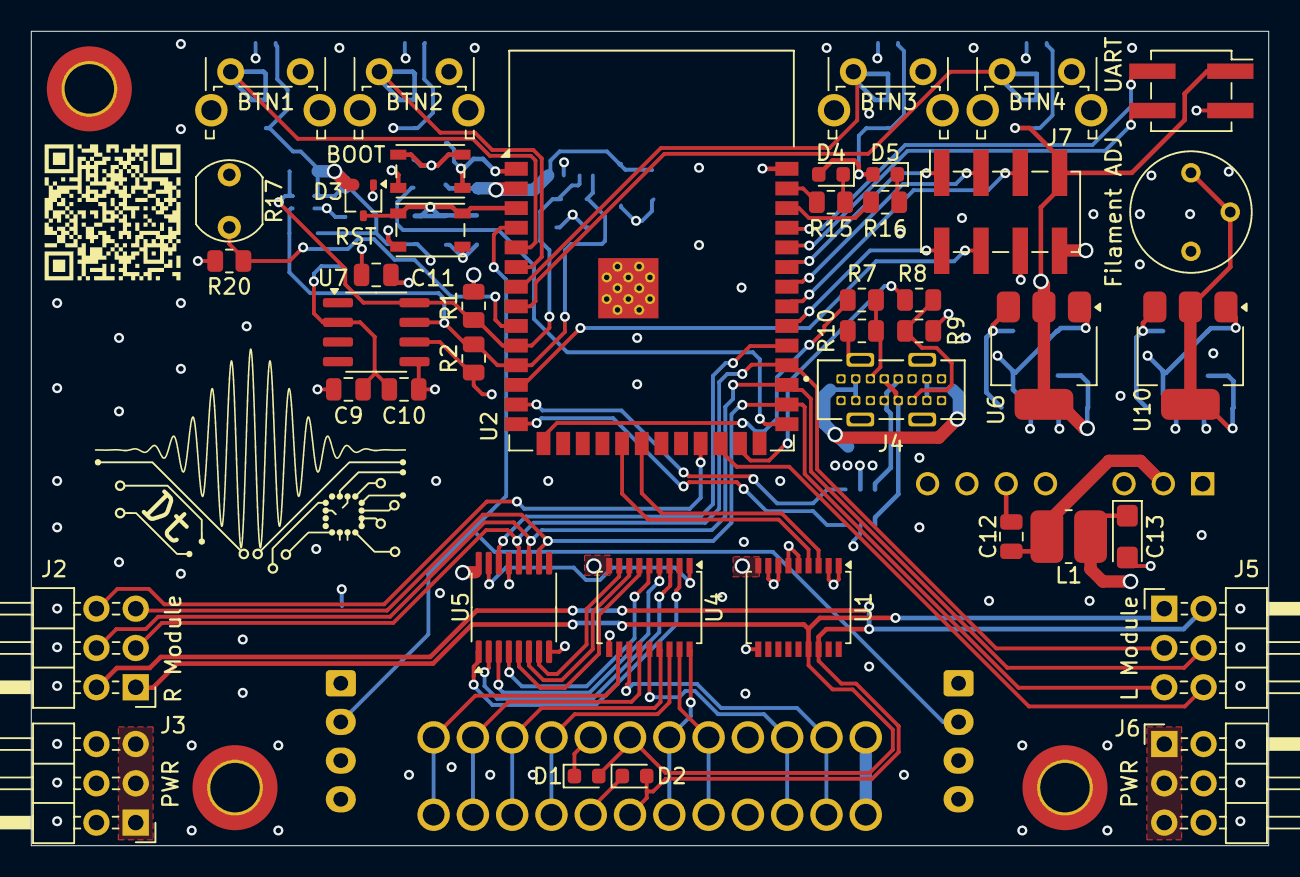
[picture p29: board VFDClock.kicad_pcb from above]

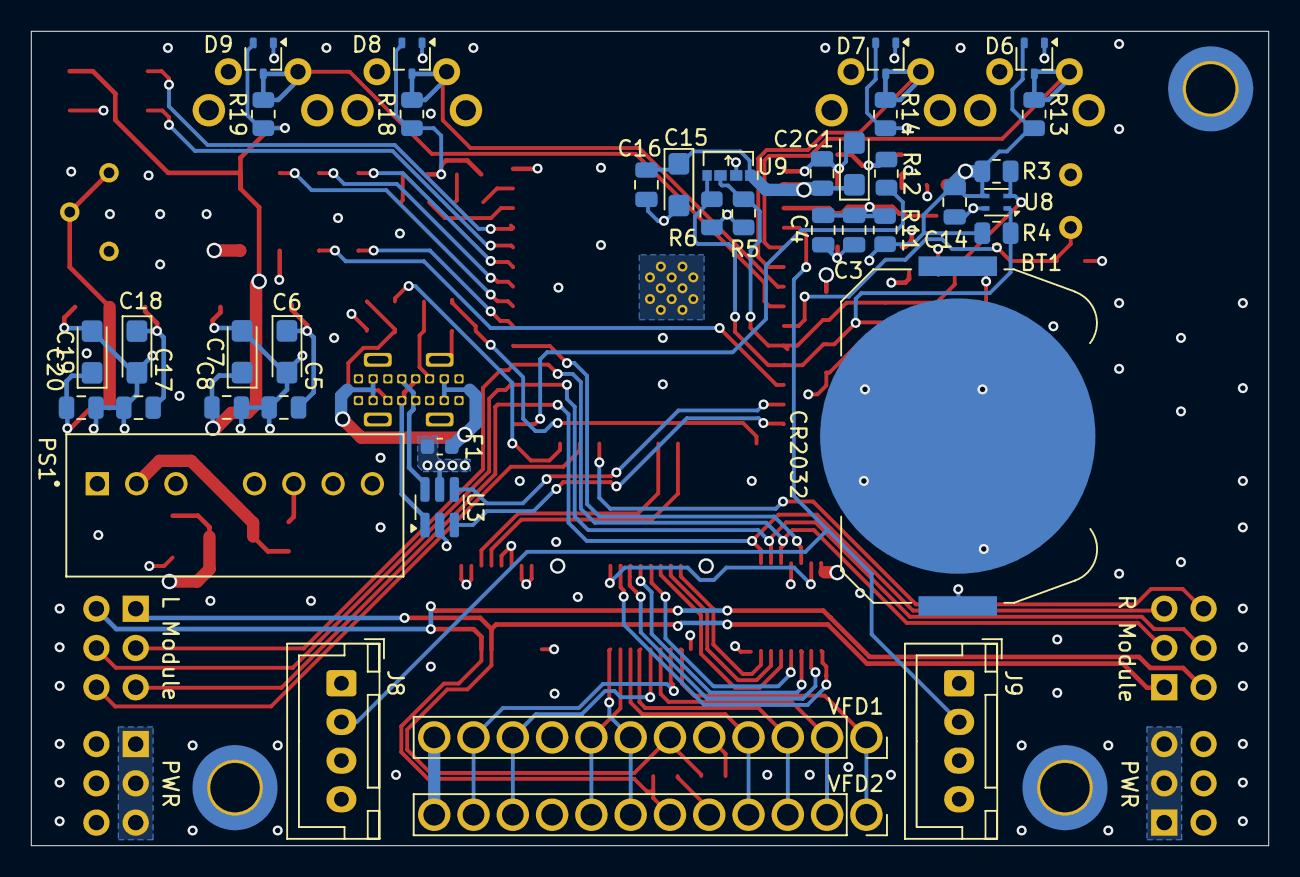
[picture p30: board VFDClock.kicad_pcb from below]

Board: 4 copper layers, 80.0 x 52.7 mm, 84 parts (39 on the bottom side), 65 nets.
