GraniteGobbler/VFDClock/separator_pcb/Separator.kicad_pcb

## KiCad design separator_pcb/Separator.kicad_pcb (2025-06-19)

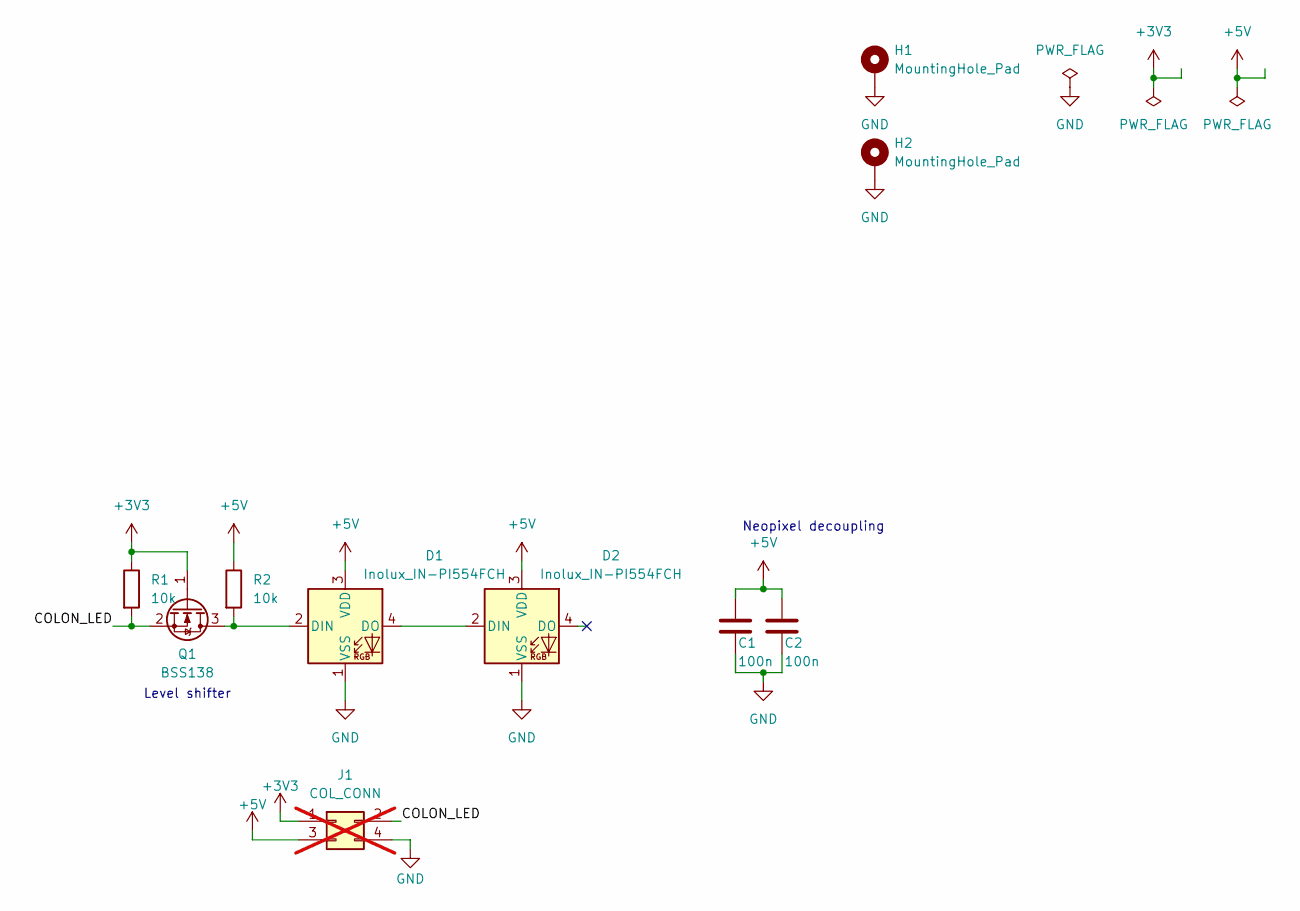
[picture p31: schematic Separator.kicad_sch]

Parts:
C1, C2: 100n; C_0805_2012Metric
D1, D2: Inolux_IN-PI554FCH; LED_Inolux_IN-PI554FCH_PLCC4_5.0x5.0mm_P3.2mm
H1, H2: MountingHole_Pad; MountingHole_3.2mm_M3_ISO14580_Pad_TopBottom
J1: COL_CONN; PinHeader_2x02_P2.00mm_Vertical; not fitted
Q1: BSS138; SOT-23
R1, R2: 10k; R_0805_2012Metric

Connections:
+3V3: J1.1, Q1.1 (G), R1.1
+5V: C1.1, C2.1, D1.3 (VDD), D2.3 (VDD), J1.3, R2.1
/COLON_LED: J1.2, Q1.2 (S), R1.2
GND: C1.2, C2.2, D1.1 (VSS), D2.1 (VSS), H1.1, H2.1, J1.4
unnamed: D1.2 (DIN), Q1.3 (D), R2.2
unnamed: D1.4 (DO), D2.2 (DIN)

Notes on the sheet:
Neopixel decoupling
Level shifter

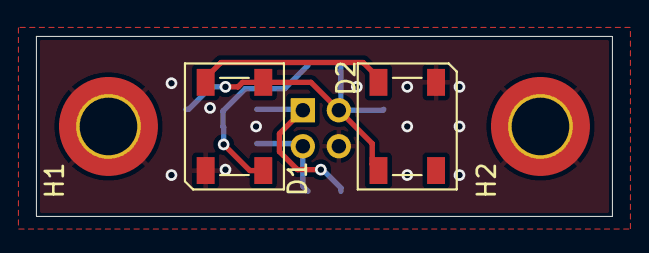
[picture p32: board Separator.kicad_pcb from above]

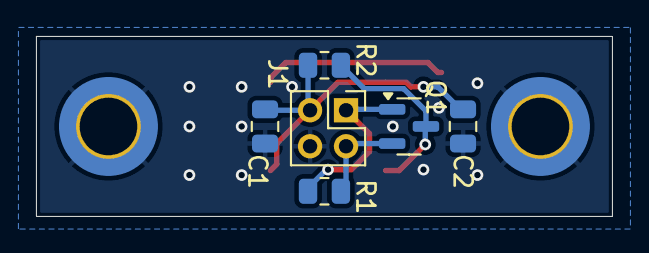
[picture p33: board Separator.kicad_pcb from below]

Board: 2 copper layers, 32.0 x 10.0 mm, 10 parts (6 on the bottom side), 6 nets.
