GraniteGobbler/VFDClock/sw/vfd_driver_with_rtc/main/main.c

#include <stdio.h>
#include <string.h>
#include <time.h>
#include <sys/time.h>
#include "freertos/FreeRTOS.h"
#include "freertos/task.h"
#include "freertos/event_groups.h"
#include "esp_system.h"
#include "esp_event.h"
#include "esp_log.h"
#include "esp_attr.h"
#include "esp_sleep.h"
#include "nvs_flash.h"
#include "protocol_examples_common.h"
#include "esp_sntp.h"

#include <math.h>
#include <inttypes.h>
#include "sdkconfig.h"
#include "driver/gpio.h"
#include "esp_timer.h"

#include "ds3231.h"
#include "vfd_driver.h"

/* Defines */
#define LED_Power   GPIO_NUM_1 // GPIO pin 1 → LED D4
#define LED_MCU     GPIO_NUM_2 // GPIO pin 2 → LED D5
#define BTN1        GPIO_NUM_5 // Rightmost button
#define BTN2        GPIO_NUM_6
#define BTN3        GPIO_NUM_7
#define BTN4        GPIO_NUM_15 // Leftmost button
#define VFD_REFRESH_PERIOD  8333 // This is half the time (in microseconds) it takes to refresh the whole display, since we are muxing the "tens" digit and the "ones" digit 
								 // 10000*2 = 20000 us = 50 fps

static const char* TAG = "VFDClock";
bool mux_select = 0;
uint8_t vfd_display_number = 0;
char vfd_display_string[] = "000000";
 

#if (ESP_IDF_VERSION >= ESP_IDF_VERSION_VAL(5, 0, 0))
#define sntp_setoperatingmode esp_sntp_setoperatingmode
#define sntp_setservername esp_sntp_setservername
#define sntp_init esp_sntp_init
#endif

#if CONFIG_SET_CLOCK
	#define NTP_SERVER CONFIG_NTP_SERVER
#endif
#if CONFIG_GET_CLOCK
	#define NTP_SERVER " "
#endif
#if CONFIG_DIFF_CLOCK
	#define NTP_SERVER CONFIG_NTP_SERVER
#endif

#define IS_DST 1
#define ONLINE_MODE 1

// static const char *TAG = "DS3213";

RTC_DATA_ATTR static int boot_count = 0;

// Handles
TaskHandle_t ledBlinkTaskHandle = NULL;
TaskHandle_t CounterTaskHandle = NULL;


// Functions
void time_sync_notification_cb(struct timeval *tv)
{
	ESP_LOGI(TAG, "Notification of a time synchronization event");
}

static void initialize_sntp(void)
{
	ESP_LOGI(TAG, "Initializing SNTP");
	sntp_setoperatingmode(SNTP_OPMODE_POLL);
	//sntp_setservername(0, "pool.ntp.org");
	ESP_LOGI(TAG, "Your NTP Server is %s", NTP_SERVER);
	sntp_setservername(0, NTP_SERVER);
	sntp_set_time_sync_notification_cb(time_sync_notification_cb);
	sntp_init();
}

static bool obtain_time(void)
{
	ESP_ERROR_CHECK( nvs_flash_init() );
	ESP_ERROR_CHECK( esp_netif_init() );
	ESP_ERROR_CHECK( esp_event_loop_create_default() );

	/* This helper function configures Wi-Fi or Ethernet, as selected in menuconfig.
	 * Read "Establishing Wi-Fi or Ethernet Connection" section in
	 * examples/protocols/README.md for more information about this function.
	 */
	ESP_ERROR_CHECK(example_connect());

	initialize_sntp();

	// wait for time to be set
	int retry = 0;
	const int retry_count = 10;
	while (sntp_get_sync_status() == SNTP_SYNC_STATUS_RESET && ++retry < retry_count) {
		ESP_LOGI(TAG, "Waiting for system time to be set... (%d/%d)", retry, retry_count);
		vTaskDelay(2000 / portTICK_PERIOD_MS);
	}

	ESP_ERROR_CHECK( example_disconnect() );
	if (retry == retry_count) return false;
	return true;
}

#if ONLINE_MODE
void setClock(void *pvParameters)
{
	// obtain time over NTP
	ESP_LOGI(pcTaskGetName(0), "Connecting to WiFi and getting time over NTP.");
	if(!obtain_time()) {
		ESP_LOGE(pcTaskGetName(0), "Fail to getting time over NTP.");
		while (1) { vTaskDelay(1); }
	}

	// update 'now' variable with current time
	time_t now;
	struct tm timeinfo;
	char strftime_buf[64];
	time(&now);
	now = now + (CONFIG_TIMEZONE*60*60) + (IS_DST*60*60);
	localtime_r(&now, &timeinfo);
	strftime(strftime_buf, sizeof(strftime_buf), "%c", &timeinfo);
	ESP_LOGI(pcTaskGetName(0), "The current date/time is: %s", strftime_buf);

	// Initialize RTC
	i2c_dev_t dev;
	if (ds3231_init_desc(&dev, I2C_NUM_0, CONFIG_SDA_GPIO, CONFIG_SCL_GPIO) != ESP_OK) {
		ESP_LOGE(pcTaskGetName(0), "Could not init device descriptor.");
		while (1) { vTaskDelay(1); }
	}

	ESP_LOGD(pcTaskGetName(0), "timeinfo.tm_sec=%d",timeinfo.tm_sec);
	ESP_LOGD(pcTaskGetName(0), "timeinfo.tm_min=%d",timeinfo.tm_min);
	ESP_LOGD(pcTaskGetName(0), "timeinfo.tm_hour=%d",timeinfo.tm_hour);
	ESP_LOGD(pcTaskGetName(0), "timeinfo.tm_wday=%d",timeinfo.tm_wday);
	ESP_LOGD(pcTaskGetName(0), "timeinfo.tm_mday=%d",timeinfo.tm_mday);
	ESP_LOGD(pcTaskGetName(0), "timeinfo.tm_mon=%d",timeinfo.tm_mon);
	ESP_LOGD(pcTaskGetName(0), "timeinfo.tm_year=%d",timeinfo.tm_year);

	struct tm time = {
		.tm_year = timeinfo.tm_year + 1900,
		.tm_mon  = timeinfo.tm_mon,  // 0-based
		.tm_mday = timeinfo.tm_mday,
		.tm_hour = timeinfo.tm_hour,
		.tm_min  = timeinfo.tm_min,
		.tm_sec  = timeinfo.tm_sec
	};

	// Save the date and time to RTC
	if (ds3231_set_time(&dev, &time) != ESP_OK) {
		ESP_LOGE(pcTaskGetName(0), "Could not set time.");
		while (1) { vTaskDelay(1); }
	}
	ESP_LOGI(pcTaskGetName(0), "Set initial date time done");

	// goto deep sleep for deep_sleep_sec seconds
	const int deep_sleep_sec = 10;
	ESP_LOGI(pcTaskGetName(0), "Entering deep sleep for %d seconds", deep_sleep_sec);
	esp_deep_sleep(1000000LL * deep_sleep_sec);
}
#else
void setClock(void *pvParameters)
{
	// Initialize RTC
	i2c_dev_t dev;
	if (ds3231_init_desc(&dev, I2C_NUM_0, CONFIG_SDA_GPIO, CONFIG_SCL_GPIO) != ESP_OK) {
		ESP_LOGE(pcTaskGetName(0), "Could not init device descriptor.");
		while (1) { vTaskDelay(1); }
	}

	struct tm time = {
		.tm_year = 2025,
		.tm_mon  = 8,  // 0-based
		.tm_mday = 18,
		.tm_hour = 12,
		.tm_min  = 20,
		.tm_sec  = 0
	};

	// Save the date and time to RTC
	if (ds3231_set_time(&dev, &time) != ESP_OK) {
		ESP_LOGE(pcTaskGetName(0), "Could not set time.");
		while (1) { vTaskDelay(1); }
	}
	ESP_LOGI(pcTaskGetName(0), "Set initial date time done");

	// goto deep sleep for deep_sleep_sec seconds
	const int deep_sleep_sec = 10;
	ESP_LOGI(pcTaskGetName(0), "Entering deep sleep for %d seconds", deep_sleep_sec);
	esp_deep_sleep(1000000LL * deep_sleep_sec);
}
#endif


void getClock(void *pvParameters)
{
	// Initialize RTC
	i2c_dev_t dev;
	if (ds3231_init_desc(&dev, I2C_NUM_0, CONFIG_SDA_GPIO, CONFIG_SCL_GPIO) != ESP_OK) {
		ESP_LOGE(pcTaskGetName(0), "Could not init device descriptor.");
		while (1) { vTaskDelay(1); }
	}

	// Initialise the xLastWakeTime variable with the current time.
	TickType_t xLastWakeTime = xTaskGetTickCount();

	// Get RTC date and time
	while (1) {
		float temp;
		struct tm rtcinfo;

		if (ds3231_get_temp_float(&dev, &temp) != ESP_OK) {
			ESP_LOGE(pcTaskGetName(0), "Could not get temperature.");
			while (1) { vTaskDelay(1); }
		}

		if (ds3231_get_time(&dev, &rtcinfo) != ESP_OK) {
			ESP_LOGE(pcTaskGetName(0), "Could not get time.");
			while (1) { vTaskDelay(1); }
		}

		// vfd_display_number = (uint8_t) rtcinfo.tm_min;
		sprintf(vfd_display_string, "%02d%02d%02d", rtcinfo.tm_hour, rtcinfo.tm_min, rtcinfo.tm_sec);

		ESP_LOGI(pcTaskGetName(0), "%04d-%02d-%02d %02d:%02d:%02d, %.2f deg Cel",
				 rtcinfo.tm_year, rtcinfo.tm_mon + 1,
				 rtcinfo.tm_mday, rtcinfo.tm_hour, rtcinfo.tm_min, rtcinfo.tm_sec, temp);
		vTaskDelayUntil(&xLastWakeTime, 100);
	}
}

void diffClock(void *pvParameters)
{
	// obtain time over NTP
	ESP_LOGI(pcTaskGetName(0), "Connecting to WiFi and getting time over NTP.");
	if(!obtain_time()) {
		ESP_LOGE(pcTaskGetName(0), "Fail to getting time over NTP.");
		while (1) { vTaskDelay(1); }
	}

	// update 'now' variable with current time
	time_t now;
	struct tm timeinfo;
	char strftime_buf[64];
	time(&now);
	now = now + (CONFIG_TIMEZONE*60*60);
	localtime_r(&now, &timeinfo);
	strftime(strftime_buf, sizeof(strftime_buf), "%m-%d-%y %H:%M:%S", &timeinfo);
	ESP_LOGI(pcTaskGetName(0), "NTP date/time is: %s", strftime_buf);

	// Initialize RTC
	i2c_dev_t dev;
	if (ds3231_init_desc(&dev, I2C_NUM_0, CONFIG_SDA_GPIO, CONFIG_SCL_GPIO) != ESP_OK) {
		ESP_LOGE(pcTaskGetName(0), "Could not init device descriptor.");
		while (1) { vTaskDelay(1); }
	}

	// Get RTC date and time
	struct tm rtcinfo;
	if (ds3231_get_time(&dev, &rtcinfo) != ESP_OK) {
		ESP_LOGE(pcTaskGetName(0), "Could not get time.");
		while (1) { vTaskDelay(1); }
	}
	rtcinfo.tm_year = rtcinfo.tm_year - 1900;
	rtcinfo.tm_isdst = -1;
	ESP_LOGD(pcTaskGetName(0), "%04d-%02d-%02d %02d:%02d:%02d", 
		rtcinfo.tm_year, rtcinfo.tm_mon + 1,
		rtcinfo.tm_mday, rtcinfo.tm_hour, rtcinfo.tm_min, rtcinfo.tm_sec);

	// update 'rtcnow' variable with current time
	time_t rtcnow = mktime(&rtcinfo);
	localtime_r(&rtcnow, &timeinfo);
	strftime(strftime_buf, sizeof(strftime_buf), "%m-%d-%y %H:%M:%S", &timeinfo);
	ESP_LOGI(pcTaskGetName(0), "RTC date/time is: %s", strftime_buf);

	// Get the time difference
	double x = difftime(rtcnow, now);
	ESP_LOGI(pcTaskGetName(0), "Time difference is: %f", x);
	
	while(1) {
		vTaskDelay(1000);
	}
}


void GPIOConfig(void){
    /*  GPIO Config */
    gpio_config_t GPIO_CONF_LED = 
    {
    .pin_bit_mask = (1ULL << LED_Power) | (1ULL << LED_MCU),    // Bit mask
    .mode = GPIO_MODE_OUTPUT,   // Pin mode
    .pull_up_en = GPIO_PULLUP_DISABLE,  // No pull-up/pull-down resistors.
    .pull_down_en = GPIO_PULLDOWN_DISABLE,
    .intr_type = GPIO_INTR_DISABLE, // No interrupt enabled.
    };

    gpio_config_t GPIO_CONF_BUTTONS = 
    {
    .pin_bit_mask = (1ULL << BTN1) | (1ULL << BTN2) | 
                    (1ULL << BTN3) | (1ULL << BTN4), // Bit mask
    .mode = GPIO_MODE_INPUT,   // Pin mode
    .pull_up_en = GPIO_PULLUP_DISABLE,  // No pull-up/pull-down resistors.
    .pull_down_en = GPIO_PULLDOWN_DISABLE,
    .intr_type = GPIO_INTR_DISABLE, // No interrupt enabled.
    };

    // Configure the GPIO with the settings.
    gpio_config(&GPIO_CONF_LED);
    gpio_config(&GPIO_CONF_BUTTONS);
}

/* LED Blink Task*/
void ledBlinkTask(void *pvParameters){
    // Turn Power LED on when "power is present"
    gpio_set_level(LED_Power, 0); 

    ESP_LOGW("ledBlinkTask", "CORE ID: %d", xPortGetCoreID());

    while(1){
            // Toggle MCU LED (D5)
            gpio_set_level(LED_MCU, 0);
            // ESP_LOGI("ledBlinkTask", "MCU LED on");
            vTaskDelay(1000 / portTICK_PERIOD_MS);

            gpio_set_level(LED_MCU, 1);
            // ESP_LOGI("ledBlinkTask", "MCU LED off");
            vTaskDelay(1000 / portTICK_PERIOD_MS);
        }
}

/*Counter Task*/
// void CounterTask(void *pvParameters){
//     uint8_t cnt = 0;
//     while (1){
        
//         vfd_display_number = (cnt++) % 100;

//         vTaskDelay(pdMS_TO_TICKS(1000));
//     }
// }

/* Timer callbacks */
void mux_callback(void *param){
    
    // vfd_value(vfd_display_number, mux_select);
	vfd_value_str(vfd_display_string, mux_select);
    mux_select = !mux_select;
}



void app_main()
{
	++boot_count;
	ESP_LOGI(TAG, "CONFIG_SCL_GPIO = %d", CONFIG_SCL_GPIO);
	ESP_LOGI(TAG, "CONFIG_SDA_GPIO = %d", CONFIG_SDA_GPIO);
	ESP_LOGI(TAG, "CONFIG_TIMEZONE= %d", CONFIG_TIMEZONE);
	ESP_LOGI(TAG, "Boot count: %d", boot_count);

#if CONFIG_SET_CLOCK
	// Set clock & Get clock
	if (boot_count == 1) {
		xTaskCreate(setClock, "setClock", 1024*4, NULL, 2, NULL);
	} else {
		xTaskCreate(getClock, "getClock", 1024*4, NULL, 2, NULL);
	}
#endif

#if CONFIG_GET_CLOCK
	// Get clock
	xTaskCreate(getClock, "getClock", 1024*4, NULL, 2, NULL);
#endif

#if CONFIG_DIFF_CLOCK
	// Diff clock
	xTaskCreate(diffClock, "diffClock", 1024*4, NULL, 2, NULL);
#endif

	/* Timer config */
	const esp_timer_create_args_t mux_timer_args =
		{
			.callback = &mux_callback,
			.name = "Mux Timer Interrupt"};

	esp_timer_handle_t mux_timer_handle;
	esp_timer_create(&mux_timer_args, &mux_timer_handle);
	esp_timer_start_periodic(mux_timer_handle, VFD_REFRESH_PERIOD);

	/* Init */
	GPIOConfig();
	vfd_init();

	/*  FreeRTOS tasks  */
	xTaskCreate(
		ledBlinkTask,		// Task func
		"LED Blink task",	// Task name
		2048,				// Stack size
		NULL,				// Task params
		1,					// Task priority
		&ledBlinkTaskHandle // Task handle
	);

	// xTaskCreate(
	// 	CounterTask,	   // Task func
	// 	"Counter task",	   // Task name
	// 	2048,			   // Stack size
	// 	NULL,			   // Task params
	// 	1,				   // Task priority
	// 	&CounterTaskHandle // Task handle
	// );

}
