GraniteGobbler/VFDClock/sw/vfd_driver_with_rtc/components/vfd_driver/vfd_driver.c

/*     
    This is a driver for IV-22 VFD tubes, based on the SN74HC595 8-bit shift register.
    

    ---------------------   --------------------- 
    |                   |   |                   |
    |   |-----a-----|   |   |   |-----a-----|   |
    |   |           |   |   |   |           |   |
    |   b           c   |   |   b           c   |
    |   |           |   |   |   |           |   |
    |   |-----d-----|   |   |   |-----d-----|   |
    |   |           |   |   |   |           |   |
    |   e           f   |   |   e           f   |
    |   |           |   |   |   |           |   |
    |   |-----g-----|   |   |   |-----g-----|   |
    |                 h |   |                 h |
    |                   |   |                   |
    ---------------------   ---------------------

*/

#include "vfd_driver.h"

void vfd_info(void)
{
    ESP_LOGI("vfd_info", "IV-22 tube driver based on the SN74HC595 8-bit Shift Register");
}

void vfd_clear(void){
    gpio_set_level(SRCLR, 0); // Clear the shift register once
    gpio_set_level(SRCLR, 1);
}

void vfd_init(void){
    // GPIO config
    gpio_config_t GPIO_CONF_VFD;
    // Bit mask
    GPIO_CONF_VFD.pin_bit_mask = (1ULL << SER_LEFT) | (1ULL << SER_MID) | (1ULL << SER_RIGHT) |
                                 (1ULL << SRCLR) | (1ULL << SRCLK) | (1ULL << RCLK) |
                                 (1ULL << DRIVER1) | (1ULL << DRIVER2);
    // Pin mode
    GPIO_CONF_VFD.mode = GPIO_MODE_OUTPUT;
    // No pull-up/pull-down resistors.
    GPIO_CONF_VFD.pull_up_en = GPIO_PULLUP_DISABLE;
    GPIO_CONF_VFD.pull_down_en = GPIO_PULLDOWN_DISABLE;
    // No interrupt enabled.
    GPIO_CONF_VFD.intr_type = GPIO_INTR_DISABLE;
    // Configure the GPIO with the settings.
    gpio_config(&GPIO_CONF_VFD);

    vfd_info();
    vfd_clear();

    gpio_set_level(RCLK, 0);

}



void vfd_update(uint8_t value){

    for(uint8_t i = 0; i < sizeof(value) * 8; i++){

        gpio_set_level(SER_MID, value & 1); // Write LSB of value to SER

		value >>= 1;

		gpio_set_level(SRCLK, 1); // Tick the shift register storage
		gpio_set_level(SRCLK, 0);
    }

    gpio_set_level(RCLK, 1); // Send SR storage to output
	gpio_set_level(RCLK, 0);
}



void vfd_value(uint8_t value, bool digit_select){
    
    // Digit mux - DRIVER1 = tens, DRIVER2 = ones
    if(digit_select == 0){
        gpio_set_level(DRIVER1, 0);
        gpio_set_level(DRIVER2, 1);

        vfd_update(number_map[value % 10]); // Extract ones
    }
    else{
        gpio_set_level(DRIVER1, 1);
        gpio_set_level(DRIVER2, 0);

        vfd_update(number_map[value / 10]); // Extract tens
    }
    
}


void vfd_update_str(uint32_t value_buf){

    for(uint8_t i = 0; i < (sizeof(uint8_t) * 8); i++){
        
        gpio_set_level(SER_LEFT, value_buf & 1); // Write LSB of value to SER        
        gpio_set_level(SER_MID, value_buf & (1 << 8));
        gpio_set_level(SER_RIGHT, value_buf & (1 << 16));

        value_buf >>= 1;

        gpio_set_level(SRCLK, 1); // Tick the shift register storage
		gpio_set_level(SRCLK, 0);
    }

    gpio_set_level(RCLK, 1); // Send SR storage to output
	gpio_set_level(RCLK, 0);
}



void vfd_value_str(const char *input_str, bool position){
    
    uint32_t value_buf = 0; // Buffer variable for outputting triplets at once

    for(uint8_t i = 0; i < 3; i++){
        char character = input_str[2*i + position];
        
        if (character >= '0' && character <= '9'){
            // vfd_update_str(number_map[character - '0'], i);
            value_buf |= number_map[character - '0'] << (8*i);    // Shift 8*i times depending on if the character is 1st, 2nd or 3rd
        }
        else if (character >= 'a' && character <= 'z'){
            // vfd_update_str(character_map[character - 'a'], i);
            value_buf |= character_map[character - 'a'] << (8*i);
        }
        else if (character >= 'A' && character <= 'Z'){
            // vfd_update_str(character_map[character - 'A'], i);
            value_buf |= character_map[character - 'A'] << (8*i);
        }

        // Digit mux - DRIVER1 = tens, DRIVER2 = ones
        if(position == 0){  // 0 = left position, 1 = right position
            gpio_set_level(DRIVER1, 1);
            gpio_set_level(DRIVER2, 0);
        }
        else{
            gpio_set_level(DRIVER1, 0);
            gpio_set_level(DRIVER2, 1);
        }
    }  

    vfd_update_str(value_buf);
}
