GraniteGobbler/VFDClock/(commit log)

2025-05-24 Added custom VFD library
    [VFDClock.kicad_pcb, VFDClock.kicad_sch]
2025-05-24 General schematic layout
    [VFDClock.kicad_pcb, VFDClock.kicad_sch]
2025-05-25 Added power supply part of schematic
    [RS3K-0524S_H3.step, VFDClock.kicad_sch]
2025-05-25 Added linear regulator for filament voltage
    [VFDClock.kicad_pcb, VFDClock.kicad_sch]
2025-05-25 Added sensors and general feature ideas
    [VFDClock.kicad_sch]
2025-05-25 Added TVS diodes
    [VFDClock.kicad_sch]
2025-05-26 Added TVS and packages for components
    [VFDClock.kicad_pcb, VFDClock.kicad_sch]
2025-05-28 Added custom footprints for VEML light sensor, added sensors and RTC, pull-ups for I2C
    [VFDClock.kicad_sch]
2025-05-30 Added footprints
    [VFDClock.kicad_pcb, VFDClock.kicad_sch]
2025-05-30 Added custom USB-C footprint
    [UJ20-C-V-C-2-SMT-TR.step, VFDClock.kicad_pcb, VFDClock.kicad_sch]
2025-05-30 Initial component placement
    [VFDClock.kicad_pcb, VFDClock.kicad_sch]
2025-05-31 Footprint placement progress
    [VFDClock.kicad_pcb, VFDClock.kicad_sch]
2025-05-31 VEML3235SL model
    [VEML3235SL.stp]
2025-05-31 Created separator_pcb
    [RS3K-0524S_H3.step, UJ20-C-V-C-2-SMT-TR.step, VEML3235SL.stp, VFDClock.kicad_pcb, VFDClock.kicad_sch]
2025-05-31 Finished separator board
    [Separator.kicad_pcb, Separator.kicad_sch, VFDClock.kicad_pcb, VFDClock.kicad_sch]
2025-05-31 Footprint placement done, PWR needs connecting
    [Separator.kicad_pcb, Separator.kicad_sch, VFDClock.kicad_pcb, VFDClock.kicad_sch]
2025-06-01 Layout done, generated fabrication files
    [PTS810SJK250SMTR_LFS-v2.STEP, PTS810SJK250SMTR_LFS.stp, SHT45-AD1B-R2.stp, Separator.kicad_pcb, Separator.kicad_sch, UJ20-C-V-C-2-SMT-TR-v2.step, VFDClock.kicad_pcb, VFDClock.kicad_sch]
2025-06-01 Readded light sensor 3D model
    [VFDClock.kicad_pcb]
2025-06-01 Rendered images of main board
2025-06-02 Modified circuit to use synchronous grid clock on all modules
    [VFDClock.kicad_pcb, VFDClock.kicad_sch]
2025-06-02 First commit for side module board
    [Module.kicad_pcb, Module.kicad_sch, PTS810SJK250SMTR_LFS-v2.STEP, PTS810SJK250SMTR_LFS.stp, RS3K-0524S_H3.step, SHT45-AD1B-R2.stp, UJ20-C-V-C-2-SMT-TR-v2.step, UJ20-C-V-C-2-SMT-TR.step]
2025-06-03 Fixed placement of mounting holes and pin headers
    [VFDClock.kicad_pcb, bom.csv, positions.csv]
2025-06-03 Layout done
    [Module.kicad_pcb, Module.kicad_sch, bom.csv, designators.csv, positions.csv]
2025-06-03 Updated gitignore to not track <pcb name>/production/backups
2025-06-04 Moved cell battery, generated STEP files
    [Module 1.22.step.SLDPRT, Module.kicad_pcb, Module_silkscreen.step.SLDPRT, Separator.step, VFDClock.kicad_pcb, positions.csv]
2025-06-04 Added 3D model for the case
    [Case.SLDPRT]
2025-06-11 Added models for VFD and socket
    [BatteryHolder_Keystone_3034_1x20mm.step.SLDPRT, Case.SLDPRT, IV-22.SLDPRT, PL31A-P.SLDPRT, Separator_PCB.step.SLDPRT, Separator_silkscreen.step.SLDPRT, VFDClock 1.77.step.SLDPRT, VFDClock.kicad_pcb]
2025-06-13 Case design rev. 1 finished
    [Case.SLDPRT, CaseCover.SLDPRT, FacePlate.SLDPRT, IV-22.SLDPRT, PL31A-P.SLDPRT, logo.dxf]
2025-06-13 MInor change in case feet
    [Case.SLDPRT]
2025-06-14 Blender import for rendering
    [M3_Torx.SLDPRT, M3x10_Torx.SLDPRT]
2025-06-16 Minor chamfer in Case. Generated .step files for print
    [Case.SLDPRT, Case.STEP, FacePlate.SLDPRT, FacePlate.STEP]
2025-06-17 Replaced capacitor footprints with EIA-3216
    [VFDClock.kicad_pcb, VFDClock.kicad_sch]
2025-06-17 Replaced capacitor footprint with EIA-3216
    [Module.kicad_pcb, Module.kicad_sch]
2025-06-17 Generated production files
    [bom.csv, designators.csv]
2025-06-19 Generated BOM
    [Module.kicad_pcb, Separator.kicad_pcb, VFDClock.kicad_pcb]
2025-06-22 Generated pcb3d files and rendered images
2025-07-25 Working counter and display driver for middle VFDs
2025-07-27 Created schematic and pinout files for ESP32-S3
    [pinout.xlsx]
2025-08-15 Missing files from last commit
    [main.c]
2025-08-18 Adjusted hole diameter
    [Case.SLDPRT]
2025-08-23 Modified hole diameters for heated insert holes, changed hole to accept a nut
    [Case.SLDPRT]
2025-08-23 Added holes for screw heads
    [FacePlate.SLDPRT]
2025-08-24 Modified supports and hole height
    [Case.SLDPRT]
2025-09-25 Modified parts to fit better
    [Case.SLDPRT, CaseCover.SLDPRT, FacePlate.SLDPRT, VFDClock_assembly.SLDASM]
